sonocotta/loud-esp/hardware/README.md

# ESP Audio Development Kits hardware 

Open Source Hardware
Open Source Software

These are the hardware design files for the ESP32 Audio Development Kit

**Prototype**



**Latest board**

| Assembed | PCB only | 
|---|---|
|  | 

## Features

### Loud-ESP Mini

| IMAGE | DESCRIPTION |
|---|---|
|  |  MCU (WROVER ESP32) <br/>  RESET and IO0/FLASH buttons <br/>  Speaker Terminals <br/>  Li-Ion Battery Connector <br/>  Power switch <br/>  USB port (Flashing + Serial + Power + Charging) <br/>  RGB LED </br>  5V Boost converter

### Loud-ESP

| IMAGE | DESCRIPTION |
|---|---|
|  |  MCU (WROVER ESP32) <br/>  RESET and IO0/FLASH buttons <br/>  Speaker Terminals <br/>  Li-Ion Battery Connector <br/>  Power switch <br/>  USB port (Flashing + Serial + Power + Charging) <br/>  RGB LED </br>  Dual 5V Boost converter <br/>  IR Sensor <br/>  TFT Screen Connector <br />  SD Card socket <br />  Rotary Encoder/Joystick module conector

#### External connectors

| IMAGE | DESCRIPTION |
|---|---|
|  |  External RGB Strip connector. Chained to built-in RGB LED <br />  External Power switch. Short via the external button to power on the board. <br />  External 5V source. Alternative source of power and charging <br />  Disable battery current protection jumper. Short to override built-in 2A current limiter (only if you know what you're doing)

### GAIN and MONO Selection

Both Boards have jumpers that can be used to configure the gain factor individually for both channels. The default GAIN is +9 dB. Short appropriate jumper to override the default
To hardwire DAC into MONO mode, you need to cut the MONO jumper (it is short by default)

| Loud-ESP MINI | Loud-ESP |
|---|---|
|  |  | 

## Board Revisions

These boards comes in multiple revisions, normally the revision of the specific board will be clearly visible on the back side of the PCB.



The current distribution of board revisions looks like this

| Revision | Loud-ESP | Revision | Loud-ESP Mini  | Description
|----|----|----|----|----|
| D |  | - |  | Extended PCB with built-in Rotary Encoder/ Joystick
| E |  | E |  | Pre-production prototype. Distributed among beta-testers
| F |  | F |  | Crowd Supply distribution
| G |  | - | - | Engineering sample that replace serial bridge with CH340 (due to few CP2102 failures reported by customers)
| H |  | - | - | Recent board update, introduce improved power topology, CH340 Serial bridge, USB-C port, and SDCARD over SDIO interface.

Reviosions A, B, and C were early prototypes, never distributed due to multiple hardware issues.

## Pin Definitions



### Pin usage summary

| PIN  | PRIMARY FUNC | JTAG | I2S  | TFT | TOUCH_TFT | RGB_LED | BAT | IR | SDCARD | ROTARY ENC/ BTN INP | PSRAM |
|---|---|---|---|---|---|---|---|---|---|---|---|
| IO0  | BOOT SEL | | | | | | | IR_IN | | | |
| IO1  | TX | | | | | | | | | | |
| IO2  | | | | | CS | | | | | | |
| IO3  | RX | | | | | | | | | | |
| IO4  | | | | DC | | | | | | | |
| IO5  | VSPI_CS | | | CS | | | | | | | |
| IO12 | HSPI_MISO | MTDI | | | | | | | | | |
| IO13 | HSPI_MOSI | MTCK | | | | | | | | | |
| IO14 | HSPI_CLK | MTMS | | | | | | | | | |
| IO15 | HSPI_CS | MTDO | | | | | | | | | |
| IO16 | | | | | | | | | | | PSRAM_CS  |
| IO17 | | | | | | | | | | | PSRAM_CLK |
| IO18 | VSPI_CLK | | | CLK | CLK | | | | CLK | | |
| IO19 | VSPI_MISO | | | MISO | MISO | | | | MISO | | |
| IO21 | | | | | | | CHRG | | | | |
| IO22 | | | DATA | | | | | | | | |
| IO23 | VSPI_MOSI | | | MOSI | MOSI | | | | MOSI | | |
| IO25 | | | WS | | | | | | | | |
| IO26 | | | CLK  | | | | | | | | |
| IO27 | | | | | | | | | CS | | |
| IO32 | | | | RES/LED | | | | | | | |
| IO33 | | | | | | OUT | | | | | |
| IO34 | | | | | | | BAT_IN | | | | |
| IO35 | | | | | | | | | | A | |
| IO36 | | | | | | | | | | B | |
| IO39 | | | | | | | | | | BTN | |

### Rev H update

Key hardware updates introduced in the rev H

- SD-CARD over SDIo interface
- CH340 Serial chip instead of CP2102
  - Few people reported its failure
- USB-C instead of mini-USB
- TPS63060 step-up/step-down 3.3V converter, which ensures smooth operation with low battery levels
  - Previous revision started flickering when battery voltage goes low, since 3V3 rail would go even below 3V, causing ESP32 brown-outs

#### SD-CARD issues

Having used Loud-ESP for a few projects involving SDCARD, I came to the idea that having 3 high-speed devices on the same SPI line is not the best approach. Since SD-CARD alternatively can be connected to the SDIO interface, I decided to follow that path in revision H.

SDIO interface is hardwired to pins IO2, IO4, IO12-15, and by the SD specification, **all must be pulled high** for reliable operation. At the same time, ESP32 specification states that **pins 2 and 12 must be low at boot**, otherwise ESP32 will go into download mode. Thus, I left them floating, which caused some SD cards to fail. I didn't find a reliable solution to this contradiction and consider going back to the SPI interface in the next revision.

#### Updated pinout

| PIN  | PRIMARY FUNC | JTAG | I2S  | TFT  | TOUCH_TFT | RGB_LED | BAT | IR | SDCARD | ROTARY ENC/ BTN INP | PSRAM |
|---|---|---|---|---|---|---|-----|---|---|---|---|
| IO0  | BOOT SEL | | | | | | | IR_IN | | | |
| IO1  | TX | | | | | | | | | | |
| IO2  | | | | | | | | | D0 | | |
| IO3  | RX | | | | | | | | | | |
| IO4  | | | | | | | | | D1 | | |
| IO5  | VSPI_CS | | | CS | | | | | | | |
| IO12 | HSPI_MISO | MTDI | | | | | | | D2 | | |
| IO13 | HSPI_MOSI | MTCK | | | | | | | D3 | | |
| IO14 | HSPI_CLK | MTMS | | | | | | | CLK | | |
| IO15 | HSPI_CS | MTDO | | | | | | | CMD | | |
| IO16 | | | | | | | | | | | PSRAM_CS  |
| IO17 | | | | | | | | | | | PSRAM_CLK |
| IO18 | VSPI_CLK | | | CLK  | CLK | | | | CLK | | |
| IO19 | VSPI_MISO | | | MISO | MISO | | | | MISO | | |
| IO21 | | | | DC | | | | | | | |
| IO22 | | | DATA | | | | | | | | |
| IO23 | VSPI_MOSI | | | MOSI | MOSI | | | | MOSI | | |
| IO25 | | | WS | | | | | | | | |
| IO26 | | | CLK  | | | | | | | | |
| IO27 | | | | | CS | | | | | | |
| IO32 | | | | LED  | | | | | | | |
| IO33 | | | | | | OUT | | | | | |
| IO34 | | | | | | | | | | B | |
| IO35 | | | | | | | | | | A | |
| IO36 | | | | | | | | | | BTN | |
| IO39 | | | | | | | | | HOST | | |

### How to use a specific peripheral

[esp32-peripheral-test](../firmware/test-peripheral/esp32-peripheral-test) firmware demonstrates how to use each of available peripheral. For many of them, you would need libraries, which are also included in this example. Of couse many alternatives can be found, example will list those that are tested and work without a hustle.
