sonocotta/loud-esp/hardware/loud-esp-rfid-edition/rev-g/2506-loud-esp-g-espuino-edition-bom.csv

ID | Name | Designator | Footprint | Quantity | Manufacturer Part | Manufacturer | Supplier | Supplier Part | Price
1 | BH-18650-B1BA002 | BT1 | BATTERY-SMD_18650-1S-L77.1-W20.7-1 | 1 | BH-18650-B1BA002 | MYOUNG(美阳) | LCSC | C2988620 | 1.31
2 | 100nF | C15,C28,C31,C32,C33,C34,C36,C39,C40,C41,C42,C43,C6,C12,C16,C21 | C0402 | 16 | CL05B104KO5NNNC | SAMSUNG | LCSC | C1525 | 0.001
3 | 1uH | L1,L2 | IND-SMD_L4.0-W4.0_SLW40XX | 2 | WPN4020H1R0MT | Sunlord(顺络) | LCSC | C98359
4 | XL-0807RGBC-WS2812B | U11,U12,U13,U14,U15,U16,U17,U18,U19,U20,U21,U22 | LED-SMD_4P-L2.0-W1.8_CY-0807 | 12 | XL-0807RGBC-WS2812B | XINGLIGHT(成兴光) | LCSC | C3646929 | 0.095
5 | 10uF | C9 | C0805 | 1 | CL21A106KAYNNNE | SAMSUNG(三星) | LCSC | C15850 | 0.011
6 | 680kΩ | R33,R43 | R0603 | 2 | 0603WAF6803T5E | UNI-ROYAL(厚声) | LCSC | C25822 | 0.001
7 | 300kΩ | R53 | R0402 | 1 | 0402WGF3003TCE | UNI-ROYAL(厚声) | LCSC | C25774 | 0.001
8 | 1uF | C7,C8,C18,C45 | C0402 | 4 | CL05A105KA5NQNC | SAMSUNG(三星) | LCSC | C52923 | 0.003
9 | ESP32-WROVER-E-N8R8 | U10 | WIFI-SMD_ESP32-WROVER-IE8MB | 1 | ESP32-WROVER-E-N8R8 | ESPRESSIF(乐鑫) | LCSC | C2973667 | 4.182
10 | HDR-F-2.54_1x8 | H1 | HDR-F-2.54_1X8 | 1 |  |  | LCSC | C225505 | 0.204
11 | IRF7319TRPBF_C5123893 | Q4 | SOIC-8_L4.9-W3.9-P1.27-LS6.0-BL | 1 | IRF7319TRPBF | TECH PUBLIC(台舟) | LCSC | C5123893 | 0.165
12 | 100kΩ | R25,R19,R22 | R0603 | 3 | 0603WAF1003T5E | UNI-ROYAL(厚声) | LCSC | C25803 | 0.001
13 | 510kΩ | R26,R18,R32,R36 | R0603 | 4 | 0603WAF5103T5E | UNI-ROYAL(厚声) | LCSC | C23192 | 0.001
14 | TS-1095S-A16B2-C2D1 | SW7,SW3,SW4,SW5,SW6,SW8 | KEY-SMD_4P-L6.0-W6.0-P4.50-LS8.6 | 6 | TS-1095S-A16B2-C2D1 | Yuandi(元迪) | LCSC | C782843 | 0.046
15 | 100nF | C1,C2,C25 | C0603 | 3 | CC0603KRX7R9BB104 | YAGEO | LCSC | C14663 | 0.002
16 | 10uF | C3,C26,C27,C35 | C0805 | 4 | CL21A106KAYNNNE | SAMSUNG | LCSC | C15850 | 0.011
17 | 100uF | C4,C29,C30,C37,C38 | CAP-SMD_L3.5-W2.8 | 5 | TAJB107K006RNJ | AVX | LCSC | C16133 | 0.372
18 | 10uF | C5 | C0603 | 1 | CL10A106KP8NNNC | SAMSUNG | LCSC | C19702 | 0.006
19 | 10uF | C10,C11,C13,C14,C19,C20,C22,C23 | C0402 | 8 | CL05A106MQ5NUNC | SAMSUNG(三星) | LCSC | C15525 | 0.005
20 | 10pF | C17,C24 | C0402 | 2 | CL05C100JB5NNNC | SAMSUNG(三星) | LCSC | C32949 | 0.005
21 | PH2.0-2PWB | CN1 | CONN-SMD_2P-P2.00_PH2.0-SPWB | 1 | PH-2P卧贴 | BOOMELE(博穆精密) | LCSC | C47647 | 0.059
22 | 1N5819WS | D2 | SOD-323_L1.8-W1.3-LS2.5-RD | 1 | 1N5819WS | Hottech(合科泰) | LCSC | C191023 | 0.01
23 | B5819W_C8598 | D3,D1 | SOD-123_L2.7-W1.6-LS3.7-RD-1 | 2 | B5819W SL | CJ(江苏长电/长晶) | LCSC | C8598 | 0.022
24 | IRM-H638T/TR2(DX) | LED1 | SENSOR-SMD_IRM-H638T-TR2-DX | 1 | IRM-H638T/TR2(DX) | Everlight Elec | LCSC | C390031 | 0.31
25 | FC-2012HRK-620D | LED2 | LED0805-R-RD | 1 | NCD0805R1 | 国星光电 | LCSC | C84256 | 0.014
26 | 17-21SUYC/TR8 | LED3 | LED0805-R-RD | 1 | KT-0805黄灯 | KENTO | LCSC | C2296 | 0.012
27 | 100 | R1,R2,R15 | R0402 | 3 | 0402WGF1000TCE | UniOhm | LCSC | C25076 | 0.001
28 | 10K | R3,R5,R7,R8,R9,R10,R11,R12,R13,R14,R16,R17,R29,R31,R41,R45,R46,R47,R48,R49,R50,R51,R52 | R0402 | 23 | 0402WGF1002TCE | UniOhm | LCSC | C25744 | 0.001
29 | 1MΩ | R20,R23,R30,R34 | R0603 | 4 | 0603WAF1004T5E | UNI-ROYAL(厚声) | LCSC | C22935 | 0.001
30 | 10kΩ | R21 | R0402 | 1 | 0402WGF1002TCE | UNI-ROYAL(厚声) | LCSC | C25744 | 0.001
31 | 100K | R24 | R0402 | 1 | 0402WGF1003TCE | UniOhm | LCSC | C25741 | 0.001
32 | 5.1kΩ | R27,R28 | R0402 | 2 | 0402WGF5101TCE | UNI-ROYAL(厚声) | LCSC | C25905 | 0.001
33 | 51kΩ | R35 | R0402 | 1 | 0402WGF5102TCE | UNI-ROYAL(厚声) | LCSC | C25794 | 0.001
34 | 2kΩ | R37,R38 | R0402 | 2 | 0402WGF2001TCE | UNI-ROYAL(厚声) | LCSC | C4109 | 0.001
35 | 100K (+3Db) | R39,R42 | R0402 | 2 | 0402WGF1003TCE | UniOhm | LCSC | C25741 | 0.001
36 | 100K (+15Db) | R44,R40 | R0402 | 2 | 0402WGF1003TCE | UniOhm | LCSC | C25741 | 0.001
37 | EC11N1525405 | SW1 | SW-TH_EC11NXXXX | 1 | EC11N1525405 | ALPSALPINE(阿尔卑斯阿尔派) | LCSC | C470749 | 1.987
38 | TS-1088-AR02016 | SW2 | SW-SMD_L3.9-W3.0-P4.45 | 1 | TS-1088-AR02016 | XUNPU(讯普) | LCSC | C720477 | 0.044
39 | CH340C | U1 | SOP-16_L10.0-W3.9-P1.27-LS6.0-BL | 1 | CH340C | WCH | LCSC | C84681 | 0.536
40 | TPS63060DSCR | U2,U3 | WSON-10_L3.0-W3.0-P0.50-BL-EP-A | 2 | TPS63060DSCR | TI(德州仪器) | LCSC | C48567 | 0.968
41 | TP4056 | U4 | ESOP-8_L4.9-W3.9-P1.27-LS6.0-BL-EP | 1 | TP4056-42-ESOP8 | TOPPOWER(南京拓微) | LCSC | C16581 | 0.177
42 | LEFT CHANNEL | U6 | CONN-TH_P3.50_KF350-3.5-2P | 1 | KF350-3.5-2P | Cixi Kefa Elec | LCSC | C474892 | 0.108
43 | RIGHT CHANNEL | U8 | CONN-TH_P3.50_KF350-3.5-2P | 1 | KF350-3.5-2P | Cixi Kefa Elec | LCSC | C474892 | 0.108
44 | PCA9555PW,118 | U9 | TSSOP-24_L7.8-W4.4-P0.65-LS6.4-BL | 1 | PCA9555PW,118 | NXP(恩智浦) | LCSC | C128392 | 0.802
45 | TYPE-C 16PIN 2MD(073) | USB1 | USB-C-SMD_TYPE-C-6PIN-2MD-073 | 1 | TYPE-C 16PIN 2MD(073) | SHOU HAN(首韩) | LCSC | C2765186 | 0.058
46 | S8050_C2146 | Q1,Q2 | SOT-23-3_L3.0-W1.7-P0.95-LS2.9-BR | 2 | S8050 | CJ | LCSC | C2146 | 0.013
47 | TF-01A | CARD1 | TF-SMD_TF-01A | 1 | TF-01A | HRO | LCSC | C91145 | 0.174
48 | MAX98357AETE+T | U5,U7 | TQFN-16_L3.0-W3.0-P0.50-BL-EP1.5 | 2 | MAX98357AETE+T | MAXIM(美信) | LCSC | C910544 | 1.339
49 | AO3401A | Q3 | SOT-23_L2.9-W1.3-P1.90-LS2.4-BR | 1 | AO3401A | AOS | LCSC | C15127 | 0.059
