sonocotta/loud-esp/hardware/loud-esp-rfid-edition/rev-g/2506-loud-esp-g-espuino-edition-3d.step

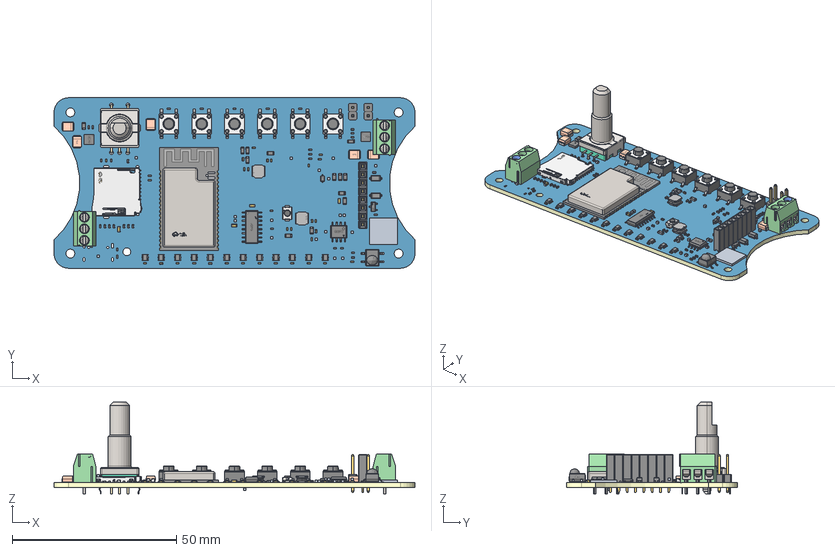
[picture p1: CAD file, 2025-10-29]
hardware/loud-esp-rfid-edition/rev-g/2506-loud-esp-g-espuino-edition-3d.step
110.0 x 52.0 x 28.0 mm
Board~B1yR
TopCopper~B1yR
BottomCopper~B1yR
TopFpcStiffener~B1yR
BottomFpcStiffener~B1yR
BATTERY-SMD_18650-1S-L77.1-W20.7-1~BATTERY-SMD_ 18650-1S-L77.1-W20.7-1~B1yR
C0805~C0805_L2.0-W1.3-H1.3~B1yR x 3
C35~C0805~C0805_L2.0-W1.3-H1.3~B1yR x 2
LED-SMD_4P-L2.0-W1.8_CY-0807~LED-SMD_4P-L2.0-W1.8_CY-0807~B1yR x 12
C0402~C0402_L1.0-W0.5-H0.5~B1yR x 30
SOIC-8_L4.9-W3.9-P1.27-LS6.0-BL~SOIC-8_L4.9-W3.9-H1.7-LS6.0-P1.27~B1yR
R0603~R0603~B1yR x 13
IND-SMD_L4.0-W4.0_SLW40XX~IND-SMD_L4.0-W4.0-H2.0_SLW40XX~B1yR x 2
R0402~R0402_L1.0-W0.5-H0.5~B1yR x 34
WIFI-SMD_ESP32-WROVER-IE8MB~WIFI-SMD_ L31.4-W18.0-H3.3-ESP32-WROVER-E~B1yR
C0603~C0603_L1.6-W0.8-H0.8~B1yR x 4
KEY-SMD_4P-L6.0-W6.0-P4.50-LS8.6~KEY-SMD_ 4P-L6.0-W6.0-H5.0-LS10.0-P4.50~B1yR x 6
CAP-SMD_L3.5-W2.8~CASE-B_L3.5-W2.8-H1.9~B1yR x 5
SOD-323_L1.8-W1.3-LS2.5-RD~SOD-323_L1.7-W1.3-H1.1-LS2.5~B1yR
SOD-123_L2.7-W1.6-LS3.7-RD-1~SOD-123_L2.7-W1.6-LS3.7-RD-1~B1yR x 2
HDR-M-2.54_1X2~HDR-M-2.54_1x2~B1yR x 2
HDR-F-2.54_1X8~HDR-F-2.54_1x8~B1yR
SENSOR-SMD_IRM-H638T-TR2-DX~SENSOR-SMD_L5.0-W4.0-H4.0-LS7.0-P2.54~B1yR
CONN-SMD_2P-P2.00_PH2.0-SPWB~CONN-SMD_2P-P2.00_PH2.0-SPWB~B1yR
SW-TH_EC11NXXXX~SW-TH_EC11NXXXX-L11.7-W12.0-H24.5-P2.5-LS14.5~B1yR
SW-SMD_L3.9-W3.0-P4.45~SW-SMD_L3.9-W2.9-H2.0-LS4.8~B1yR
LED3~LED0805-R-RD~LED0805-RD~B1yR x 2
R38~R0402~R0402_L1.0-W0.5-H0.4~B1yR x 6
TSSOP-24_L7.8-W4.4-P0.65-LS6.4-BL~TSSOP-24_ L7.8-W4.4-H1.0-LS6.4-P0.65~B1yR
SOP-16_L10.0-W3.9-P1.27-LS6.0-BL~SOP-16_ L9.9-W3.9-H1.5-LS6.0-P1.27~B1yR
ESOP-8_L4.9-W3.9-P1.27-LS6.0-BL-EP~ESOP-8_ L4.9-W3.9-H1.6-LS6.0-P1.27~B1yR
CONN-TH_P3.50_KF350-3.5-2P~CONN-TH_P3.50_KF350-3.5-2P~B1yR x 2
TQFN-16_L3.0-W3.0-P0.50-BL-EP1.5~TQFN-16_L3.0-W3.0-H0.8-P0.50~B1yR x 2
SOT-23_L2.9-W1.3-P1.90-LS2.4-BR~SOT-23-3P_ L2.9-W1.3-H1.0-LS2.4-P0.95~B1yR
USB-C-SMD_TYPE-C-6PIN-2MD-073~USB-C-SMD_TYPE-C-6PIN-2MD-073~B1yR
Q2~SOT-23-3_L3.0-W1.7-P0.95-LS2.9-BR~SOT-23-3L_ L2.9-W1.6-H1.1-LS2.8-P0.95~B1yR x 2
TF-SMD_TF-01A~TF-SMD_L14.8-W14.5-H1.9-P1.1~B1yR
