sonocotta/loud-esp/(threads)

Thread 2 (2022-07-27):

Update

fl0r1s, 2022-07-27:
Hi

I was looking to build several wifi speakers with DAC for my home multiroom audio solution, I would like to contribute or pre-order if that would already be possible. I saw that the latest activity was 4m ago, are you still working on this project? Looks super cool.

anabolyc, 2022-07-27:
Hi @fl0r1s . I'm working on the Crowd Supply campaign at the moment, and hope that boards will be available for buying soon. At this moment I can offer you pre-production samples for beta-testing. Please reach me out at andriy@sonocotta.com, I'd really like to hear what are you building and how can I support you in it.

anabolyc, 2023-03-02:
Hi @fl0r1s . [Campaign](https://www.crowdsupply.com/sonocotta/loud-esp) is live now.

Thread 3 (2022-12-15):

Actual hardware source CAD is missing

Goury, 2022-12-15:
Where is it?
Can't find it, PDF is not source code, it's mostly useless.

anabolyc, 2022-12-15:
Hi @Goury it is created in web IDE, so not much more I can share in terms of schematics. As for PCB, I can (and will) upload PDFs for PCB as well.

Can you please share what are you looking for exactly?

Goury, 2022-12-15:
@anabolyc it was created in EasyEDA, so you can totally share wither by a link or by exporting a file (yup, it does let you save a file locally)
Please do that, a PDF is useless.

Right-click the project in the Project tab, manage→share, fill the form, get the link
Here's an example: https://oshwlab.com/goury/light

anabolyc, 2022-12-15:
> it does let you save a file locally

Good to know. But since I'm in the middle of crowd supply campaign preparation, I'm sure you'll understand, not looking to provide an easy way to clone the board.

> PDF is useless

again useless for what exactly? what are you trying to do?

Goury, 2022-12-15:
> what are you trying to do?

@anabolyc clone the board of course.

You can't claim it's under GNU GPL or call it "free hardware" if you don't share the actual source.
At least sell the source files for a price.
Or put a promise to release em at a certain date and

Goury, 2022-12-15:
Also github GUI is &#%!

anabolyc, 2022-12-15:
I'm plan to release full source after campaign finishes. For now cannot give you exact date though.

anabolyc, 2022-12-15:
I'm plan to release full source after campaign finishes. For now cannot give you exact date though.

> You can't claim it's under GNU GPL or call it "free hardware" if you don't share the actual source.

I'm pretty sure I can. You have schematics, you're free to use it in your work. Open hardware doesn't imply easy cloning, I'm afraid

Goury, 2022-12-15:
> plan to release

Noice, ping this thread when it happens please.

> Open hardware doesn't imply easy cloning

It does, but I don't feel like challenging this in a court of law.
One of the ideas is that no one is in control of the hardware
If a user can't easily clone of modify it, it's not open.

01GOD, 2023-09-06:
Sigh...such a letdown. Totally thought the EDA files were in the repo because it said "open source".

I'd truly appreciate the EDA files. I have one of those touchscreens here now. I'm planning to modify it, but I'd appreciate it as a good PCB design reference as I am still learning PCB design.

Thanks in advance for posting those EDA files this week.

01GOD, 2023-09-06:
The crowdfunding page said that was fully funded in April and it's already September now.

anabolyc, 2023-09-06:
Hey @Goury @01GOD just [added](https://github.com/sonocotta/esp32-audio-development-kit/commit/d3850d11cdd37943bcafe332e667b731caa46f93) EasyEDA exported jsons. You may have a look.

01GOD, 2023-09-08:
@anabolyc : Thanks for posting those. Sadly the schematic and PCB seem to be unlinked when opened that way though. Posting that on oshwlab.com (it's a JLC thing) would make it easy to open directly in the editor and the schematic and PCB should stay linked that way. Alternatively, can export Altium project from EasyEDA. On the right track though, so thanks in advance for posting that!

01GOD, 2023-09-08:
@anabolyc : PS: Recommend the best online repository of PCB modules? (common modules, such as DAC reference board designs and so on) Thankfully at the point where ready to build board designs from such modules.

Closed 2024-04-25.

Thread 10 (2024-04-25):

Hardware pull request proposals.

picli3, 2024-04-25:
Hi Sonocotta.

I have done a project similar to this, for a different purpose. I'm mainly interested in your code. I don't know how open you are to accepting pull requests for PCB redesign but in Kicad.

my website is [personal web](https://maykolrey.com)

anabolyc, 2024-04-26:
Hi @picli3

This project evolved into [esparagus-media-center](https://github.com/sonocotta/esparagus-media-center), so I do not expect too many changes to come into the design. If the Kicad version would help you develop your variation, go ahead. If I can help, let me know. But for me personally, the Kicad version would not present too much value.

I would propose you to continue your work in the fork. I think this would present a good use case for a new open-source product that is based on the top of the other open-source project

Closed 2025-05-30.
