sonocotta/loud-esp/hardware/esp32-audio-dev-mini/loud-esp-mini-rev-e-schematic.pdf

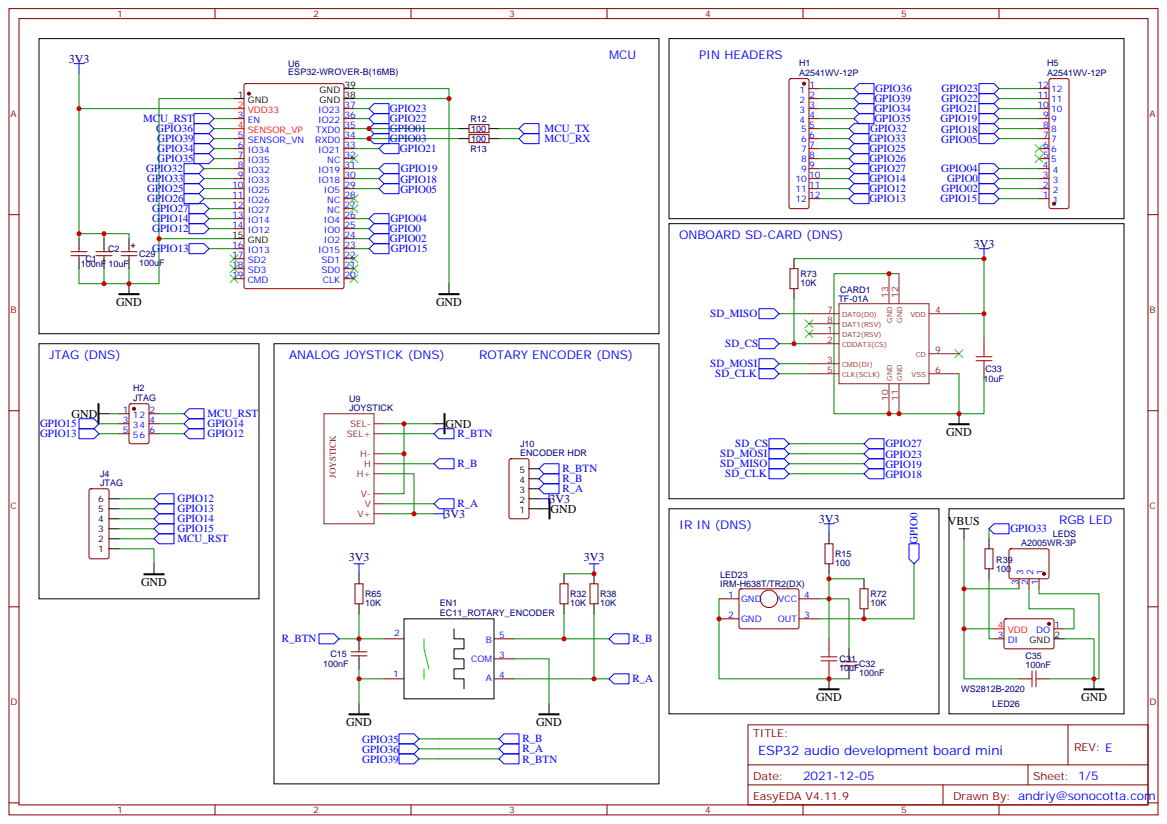
[picture p2: page 1]

ONBOARD SD-CARD (DNS)

TITLE:
ESP32 audio development board mini

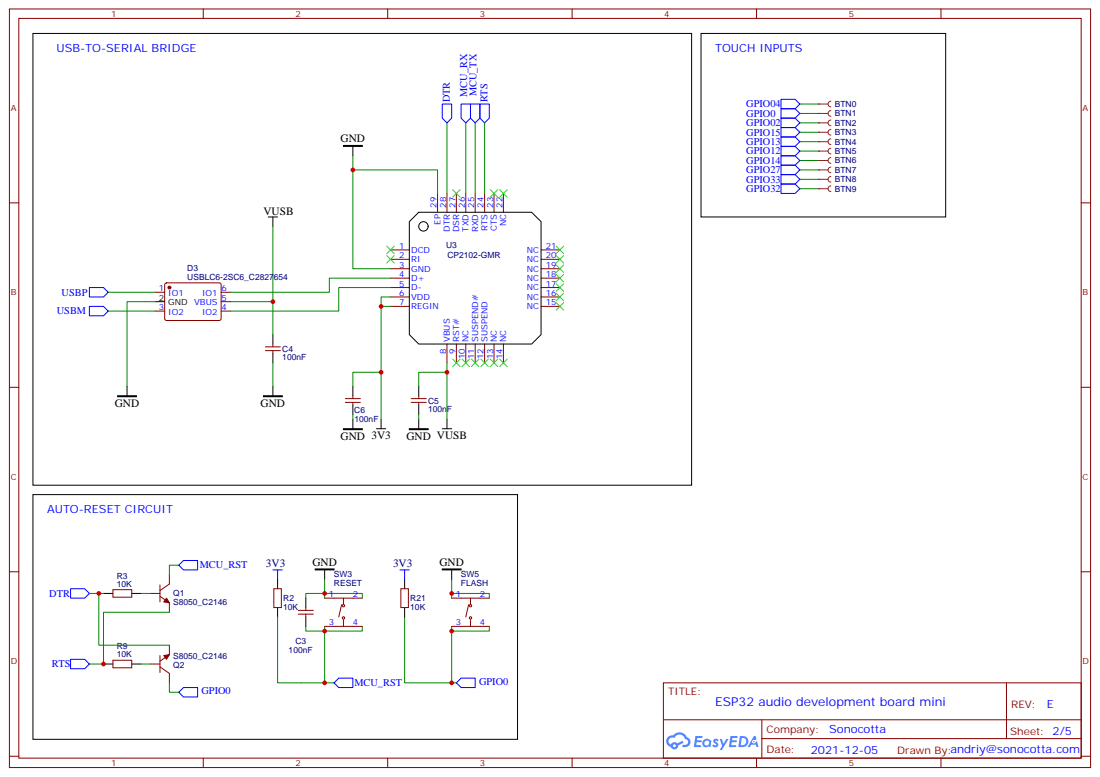
[picture p3: page 2]

USB-TO-SERIAL BRIDGE

NC 22 CTS 23 RTS 24 RXD 25 TXD 26 DSR 27 DTR 28 EP 29

Drawn By:andriy@sonocotta.com

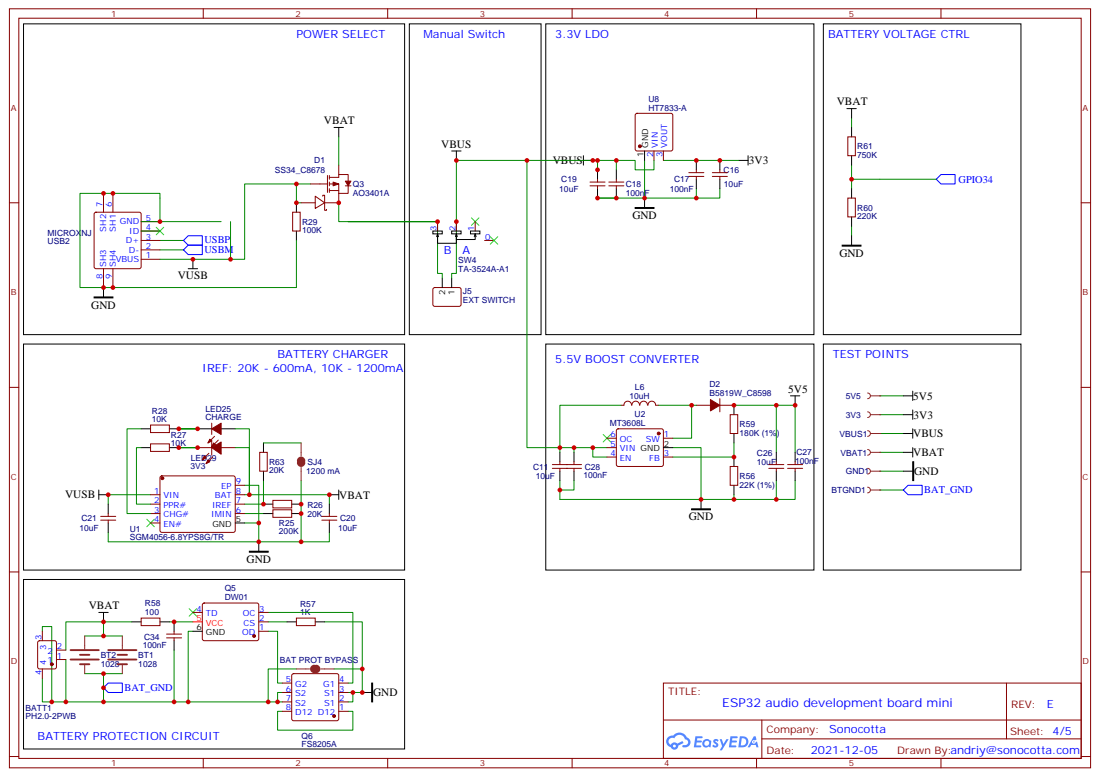
[picture p4: page 3]

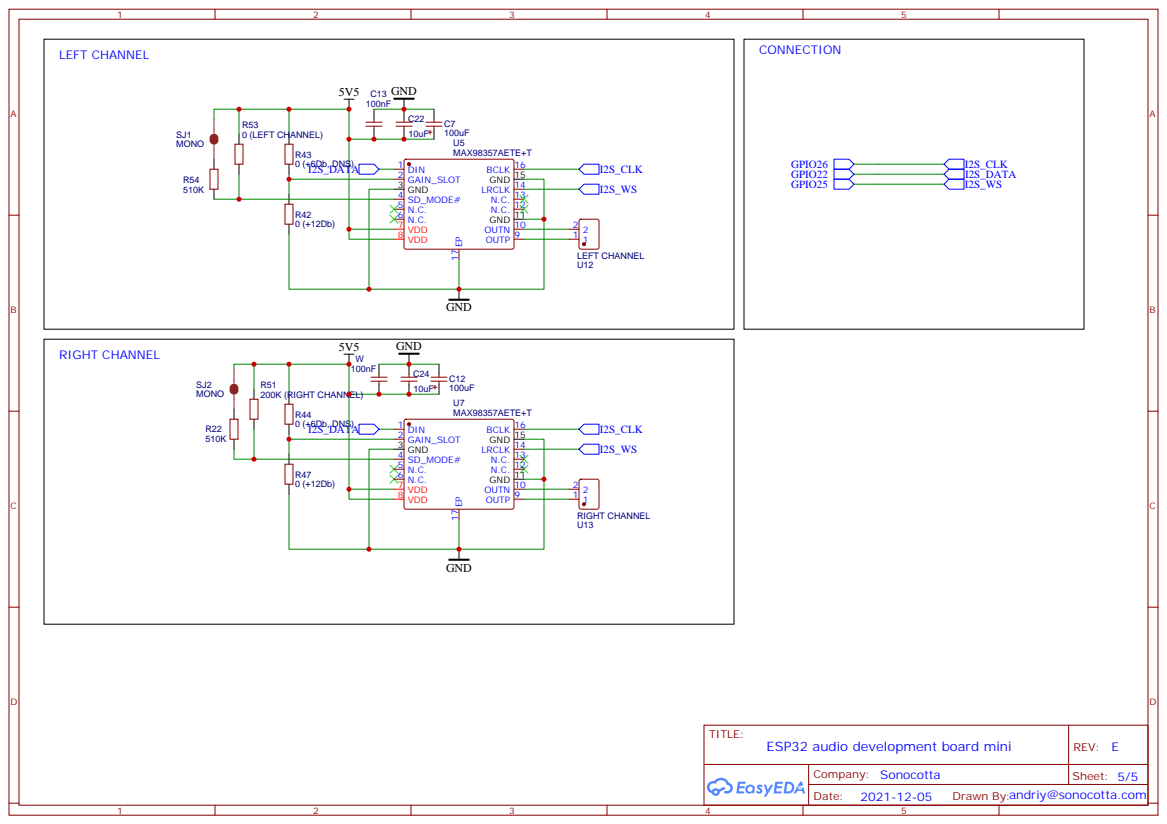
[picture p5: page 4]
