sonocotta/loud-esp/hardware/esp8266-audio-dev-mini/esp8266-audio-board-mini-rev-E.pdf

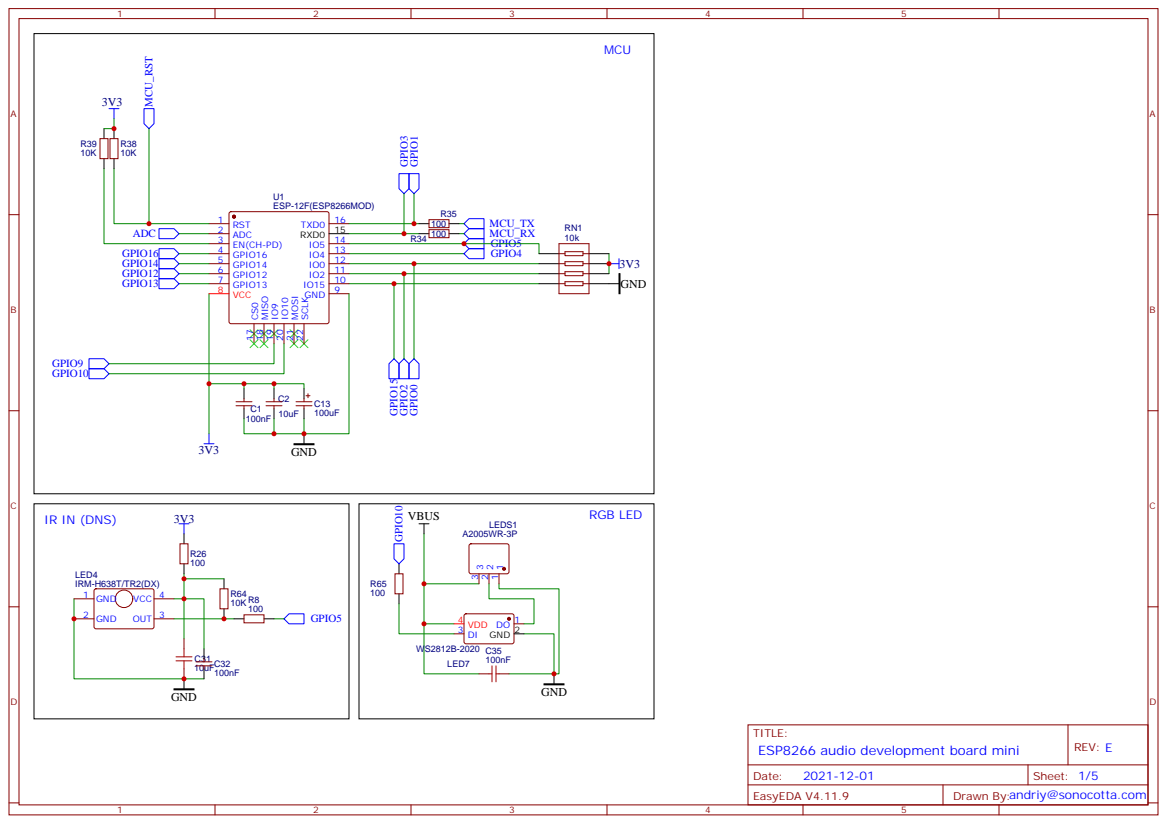
[picture p6: page 1]

TITLE:
ESP8266 audio development board mini

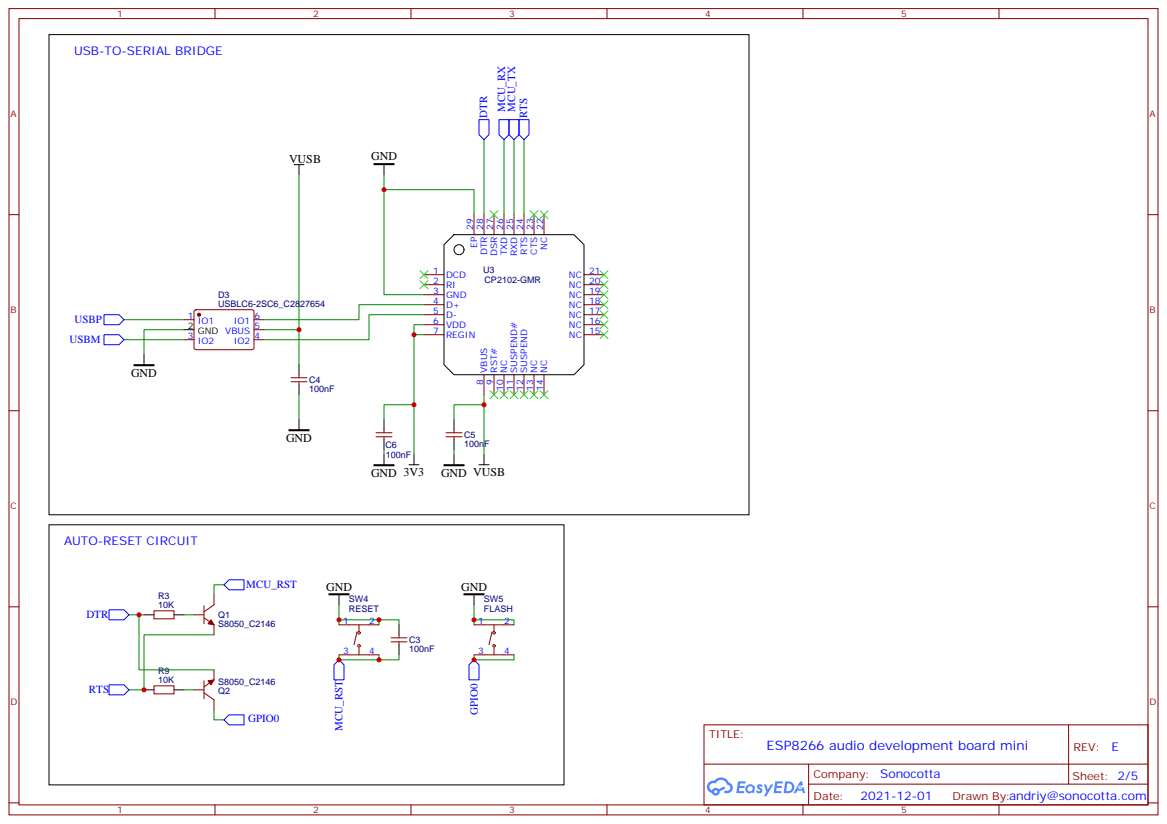
[picture p7: page 2]

USB-TO-SERIAL BRIDGE

NC 22 CTS 23 RTS 24 RXD 25 TXD 26 DSR 27 DTR 28 EP 29

Drawn By:andriy@sonocotta.com

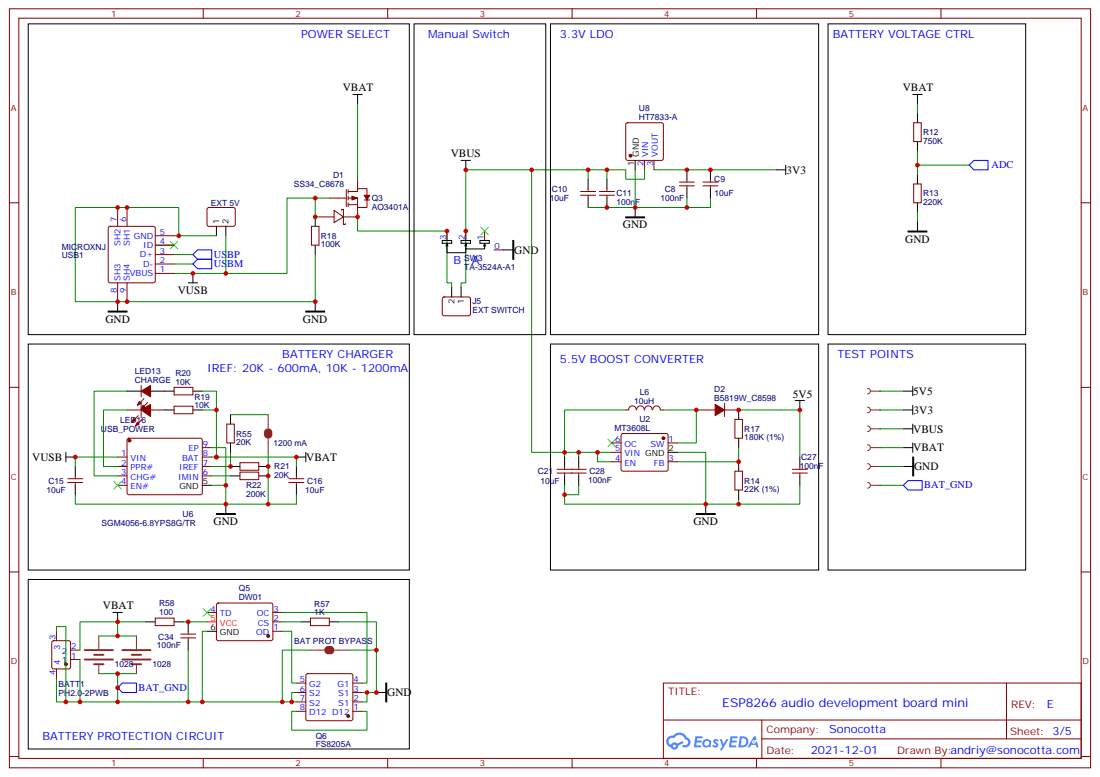
[picture p8: page 3]

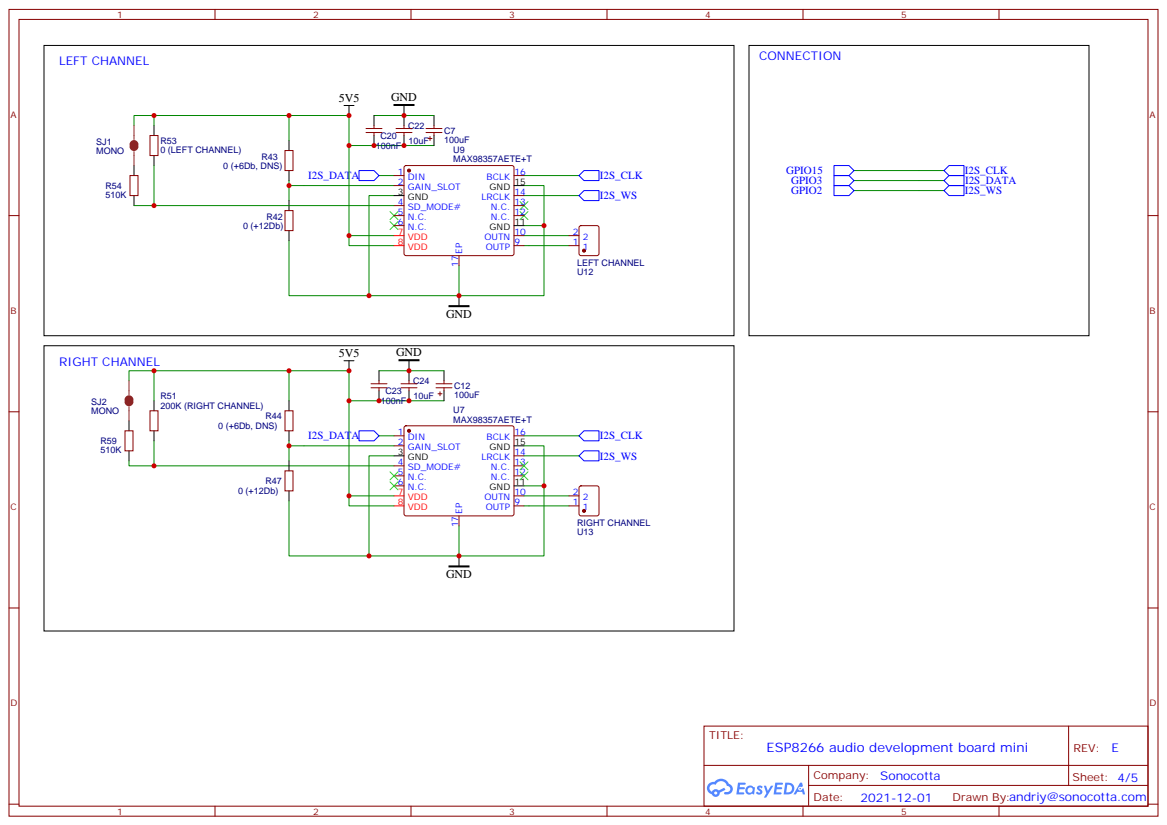
[picture p9: page 4]
