sonocotta/loud-esp/hardware/esp32-audio-dev/rev-h/2504-loud-esp-h-schematics.pdf

## MCU

## USB-TO-SERIAL BRIDGE

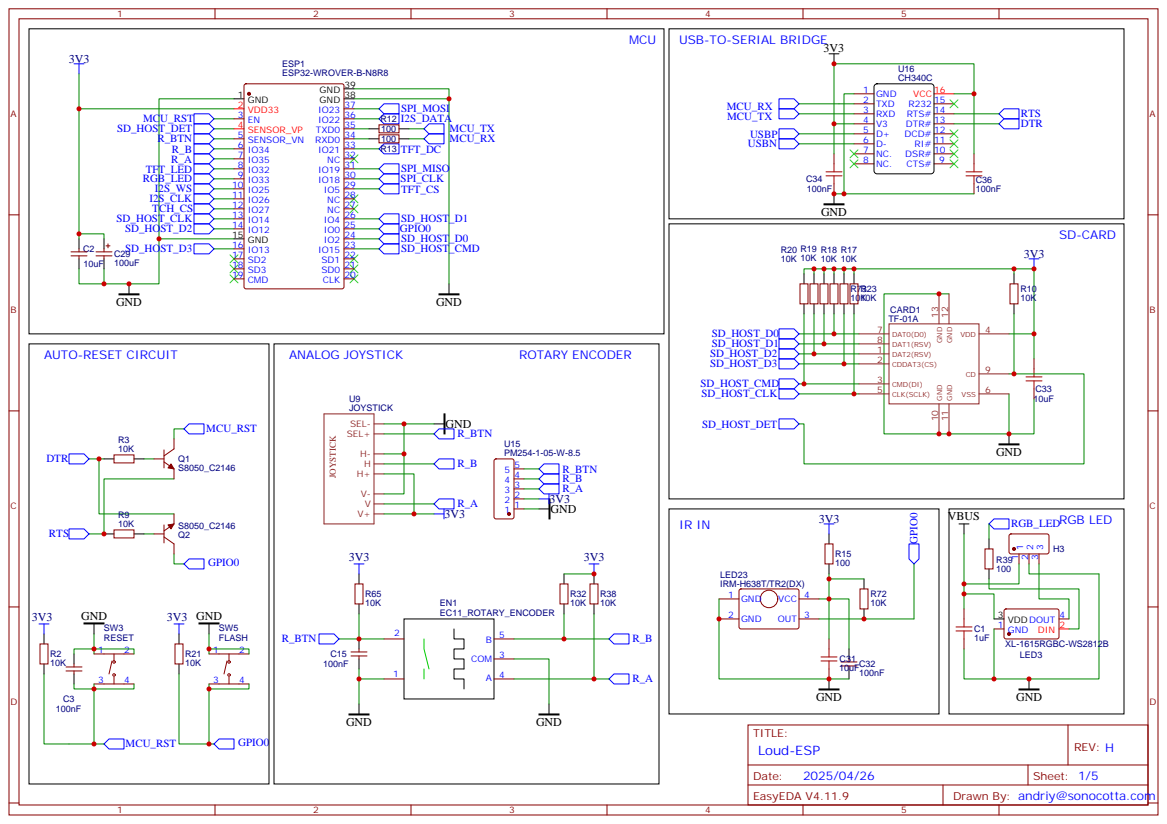
[picture p10: page 1]

POWER SELECT | Manual Switch | 3.3V LDO

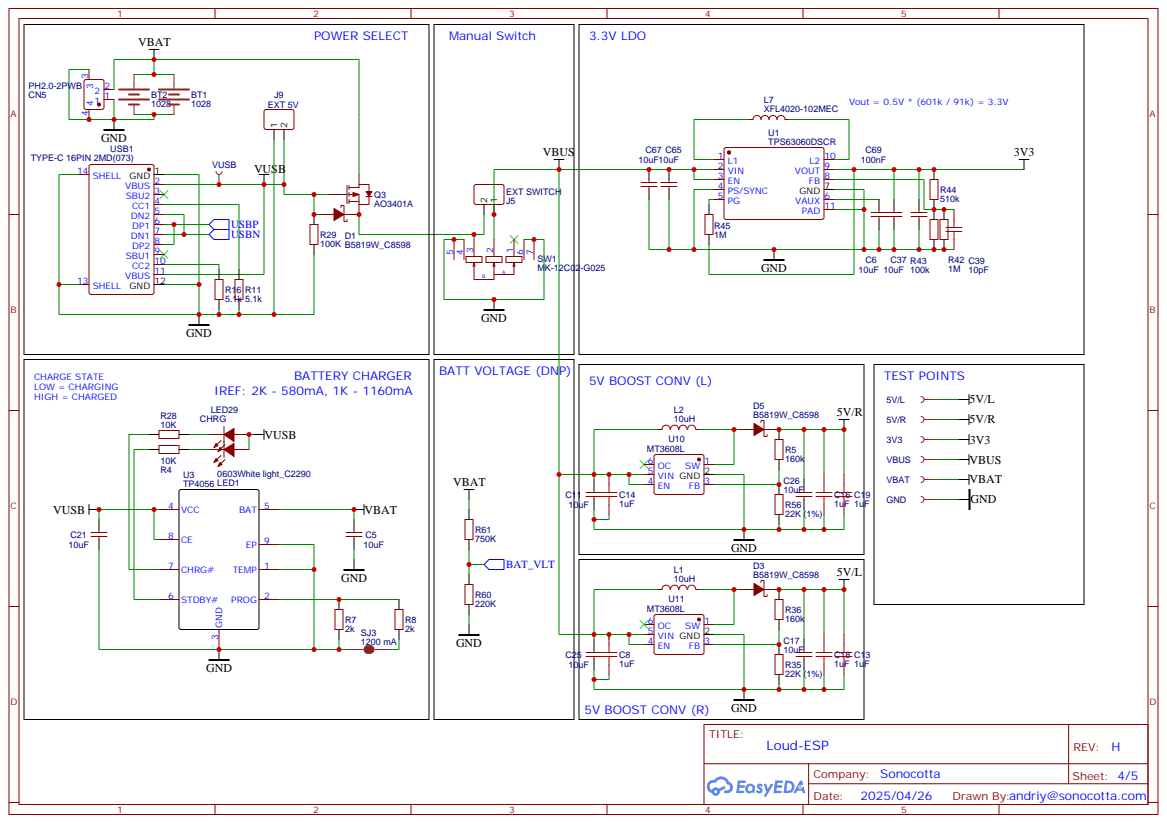
[picture p11: page 2]

BATT VOLTAGE (DNP) BATTERY CHARGER

Drawn By:andriy@sonocotta.com

## LEFT CHANNEL (L) SD_MODE HIGH, CUT TO SWITCH TO MONO (R_LARGE ~634K)

## 2.4' ST7789 TFT

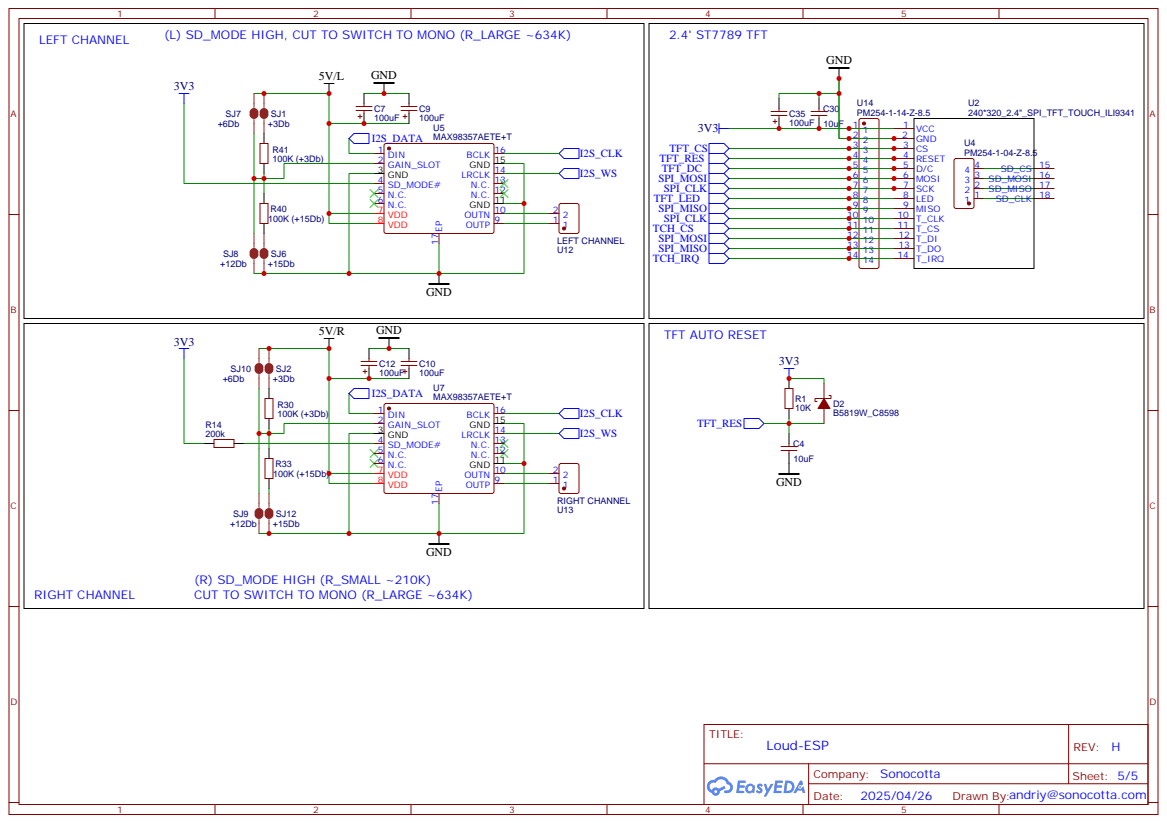
[picture p12: page 3]

(R) SD_MODE HIGH (R_SMALL ~210K)
CUT TO SWITCH TO MONO (R_LARGE ~634K)

Drawn By:andriy@sonocotta.com
