sonocotta/loud-esp/hardware/loud-esp-mini/rev-f/loud-esp-mini-rev-f-schematic.pdf

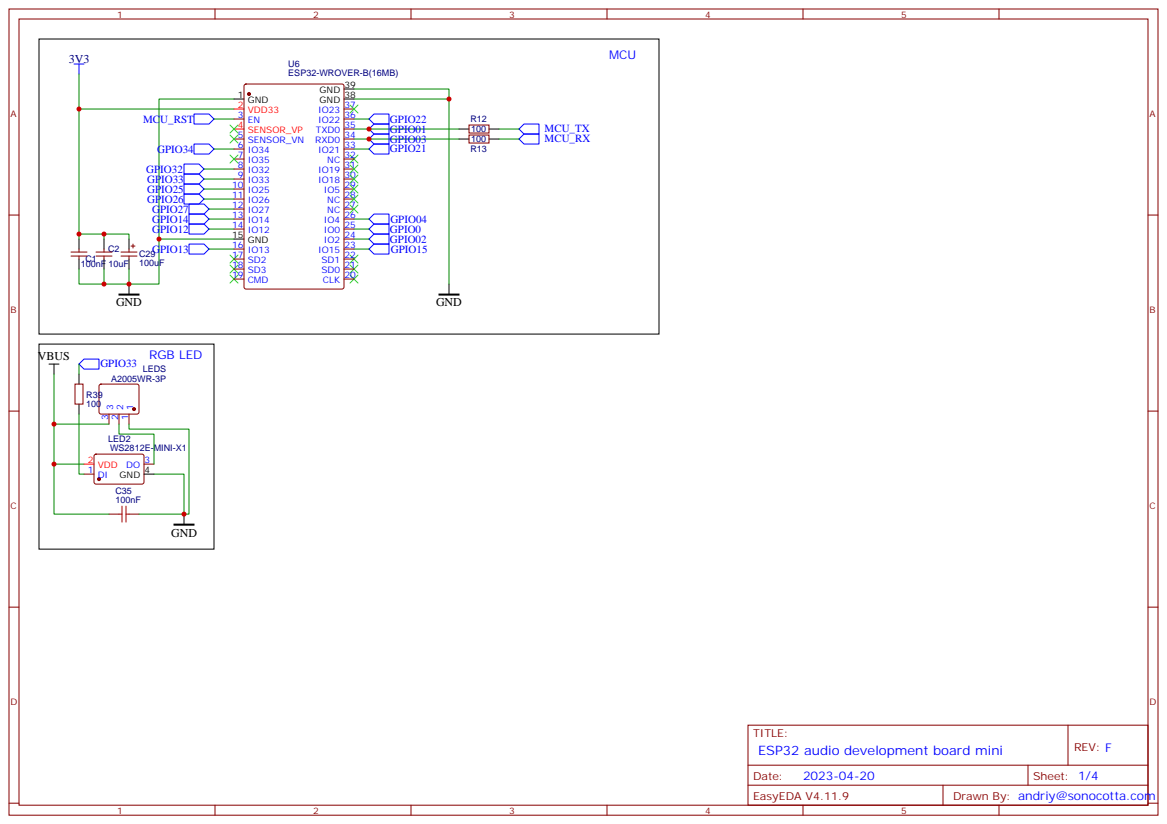
[picture p13: page 1]

TITLE:
ESP32 audio development board mini

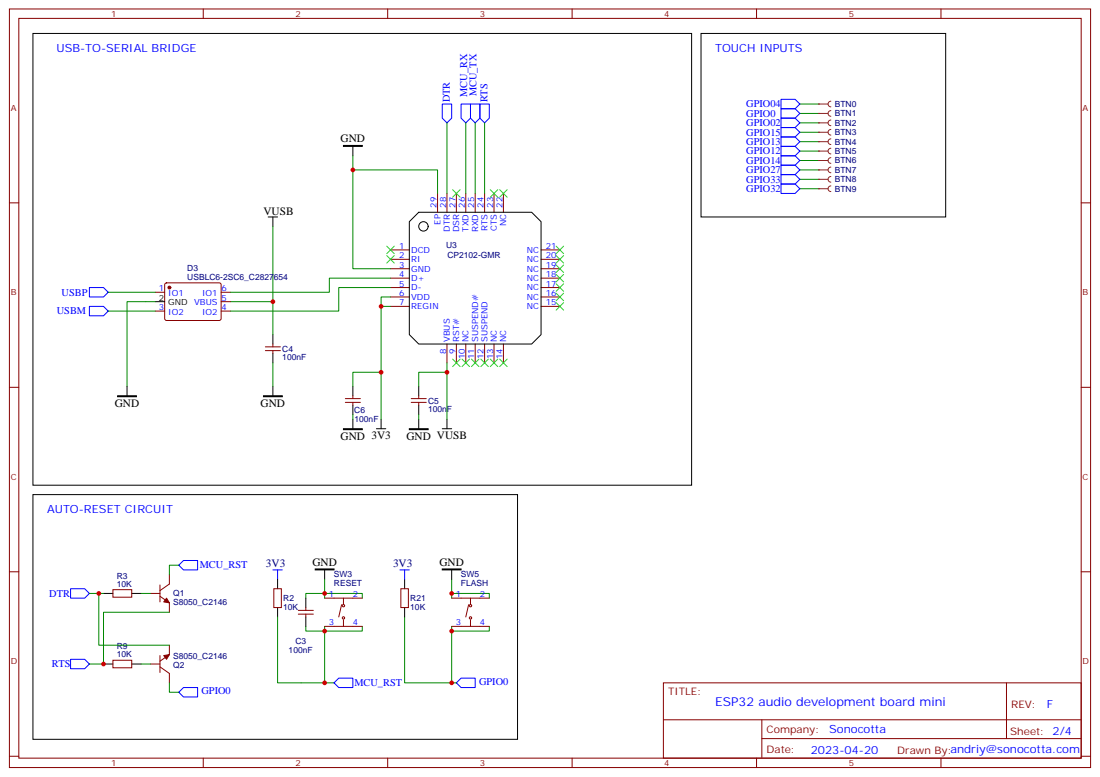
[picture p14: page 2]

USB-TO-SERIAL BRIDGE

NC 22 CTS 23 RTS 24 RXD 25 TXD 26 DSR 27 DTR 28 EP 29

Drawn By:andriy@sonocotta.com

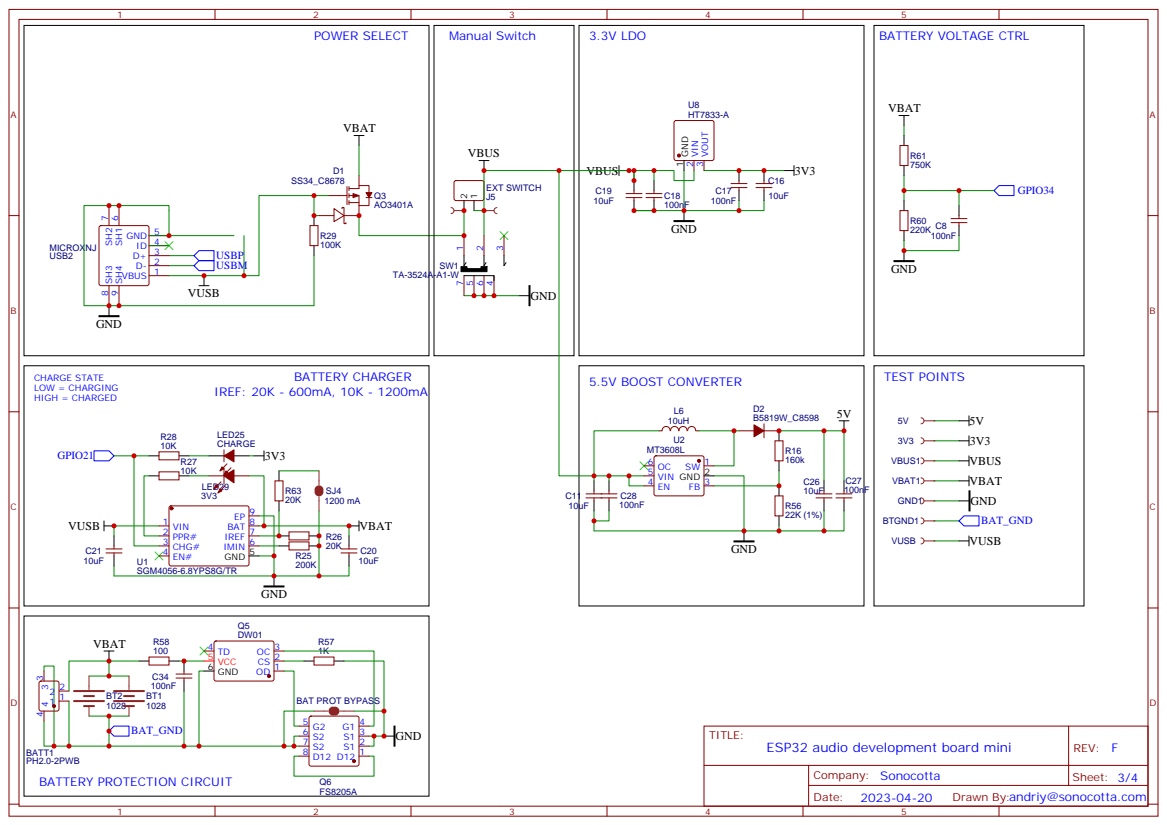
[picture p15: page 3]

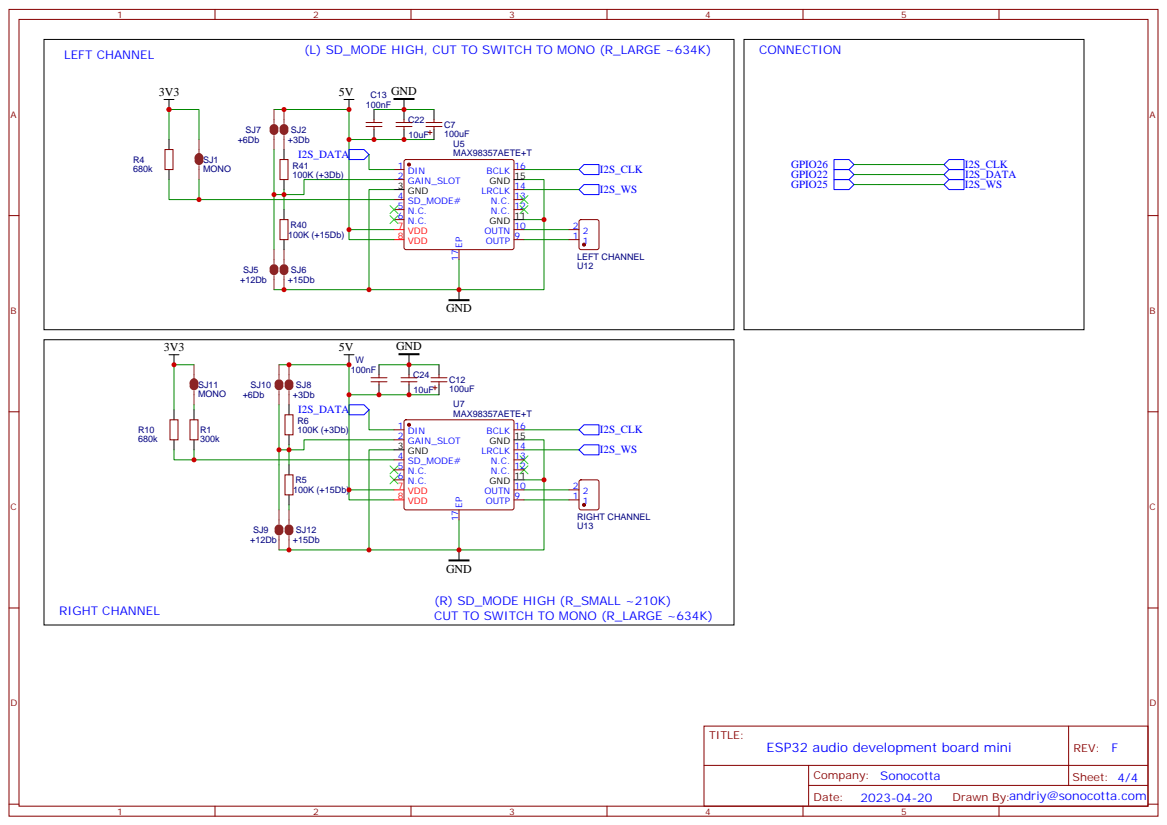
[picture p16: page 4]

(R) SD_MODE HIGH (R_SMALL ~210K)
CUT TO SWITCH TO MONO (R_LARGE ~634K)
