sonocotta/loud-esp/hardware/esp32-audio-dev-mini/loud-esp-mini-rev-e-pcb.pdf

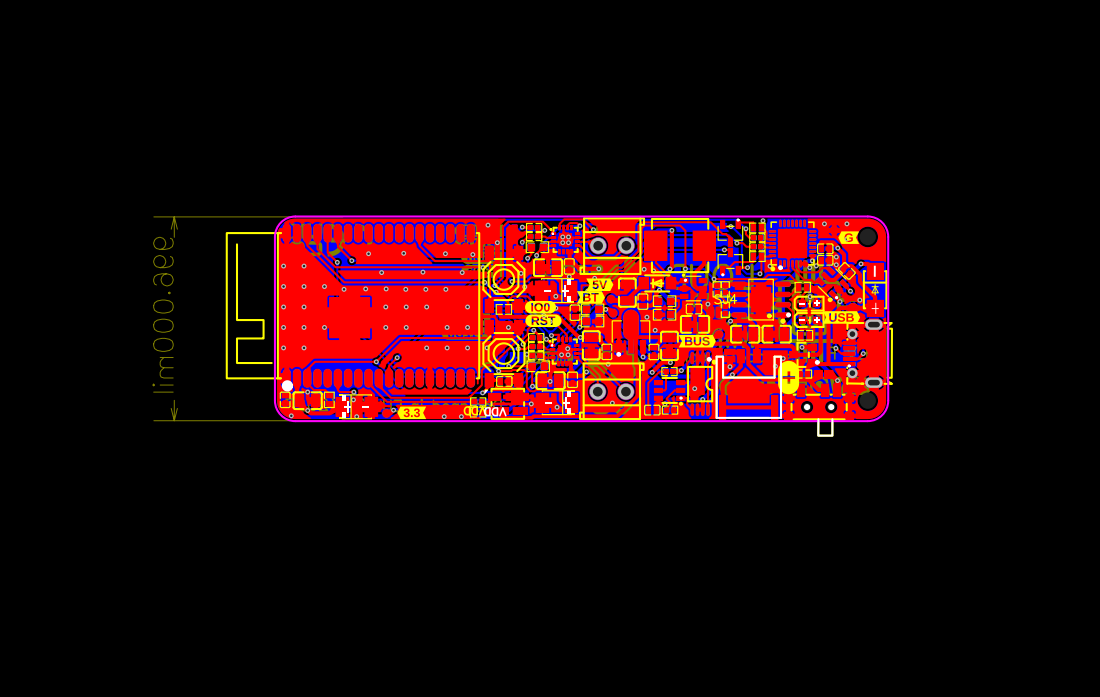
[picture p17: page 1]
