sonocotta/loud-esp/hardware/esp8266-audio-dev/esp8266-audio-board-rev-e.pdf

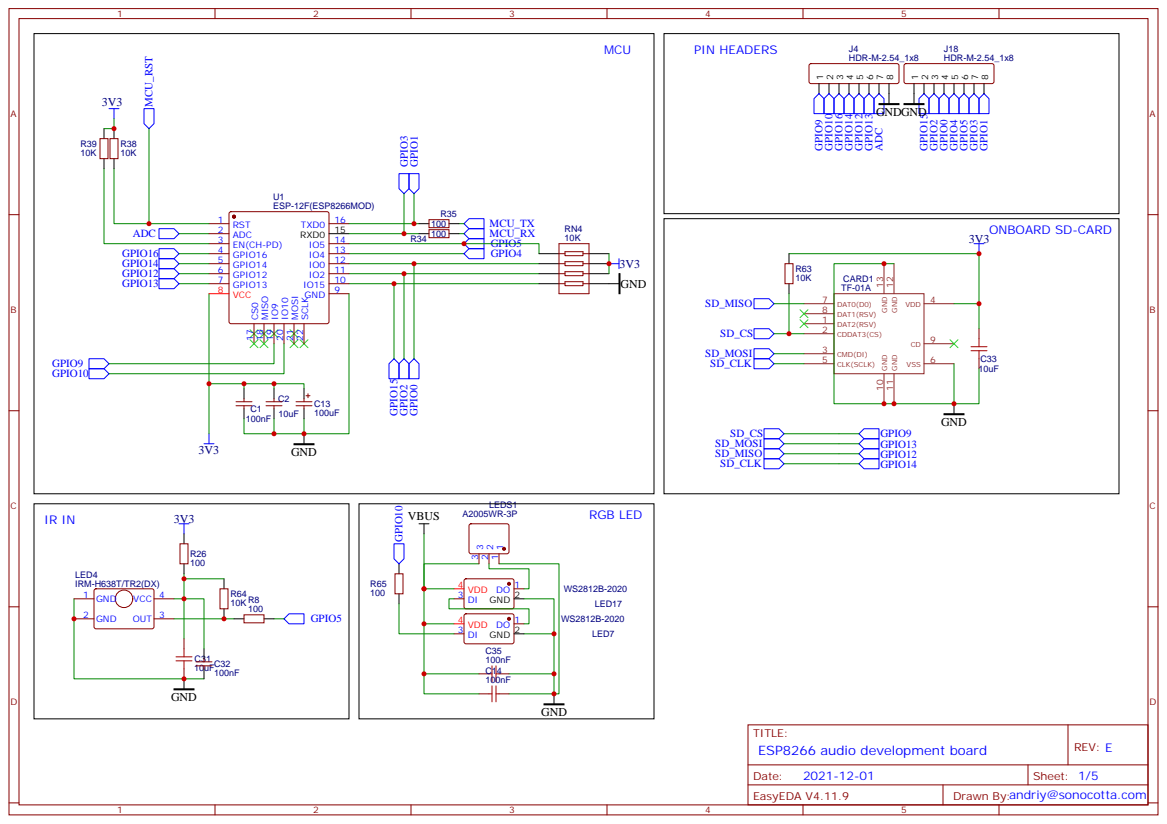
[picture p18: page 1]

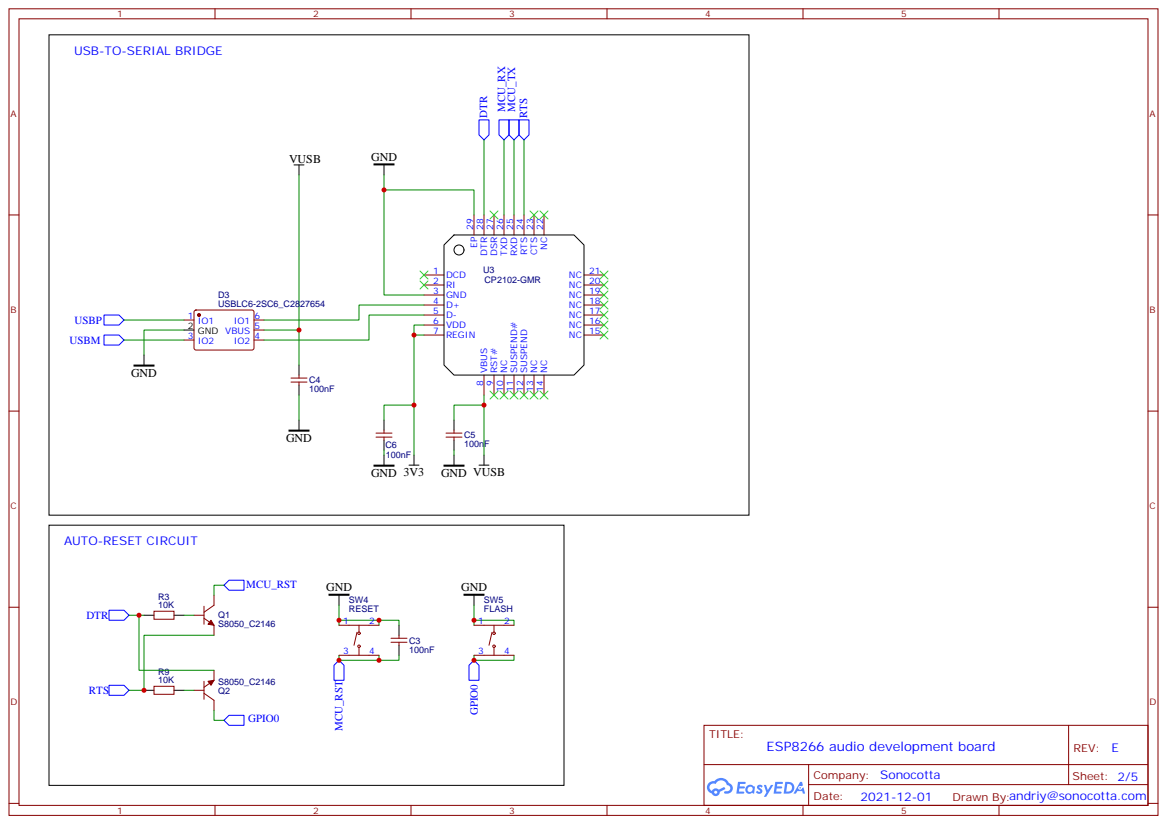
[picture p19: page 2]

USB-TO-SERIAL BRIDGE

NC 22 CTS 23 RTS 24 RXD 25 TXD 26 DSR 27 DTR 28 EP 29

Drawn By:andriy@sonocotta.com

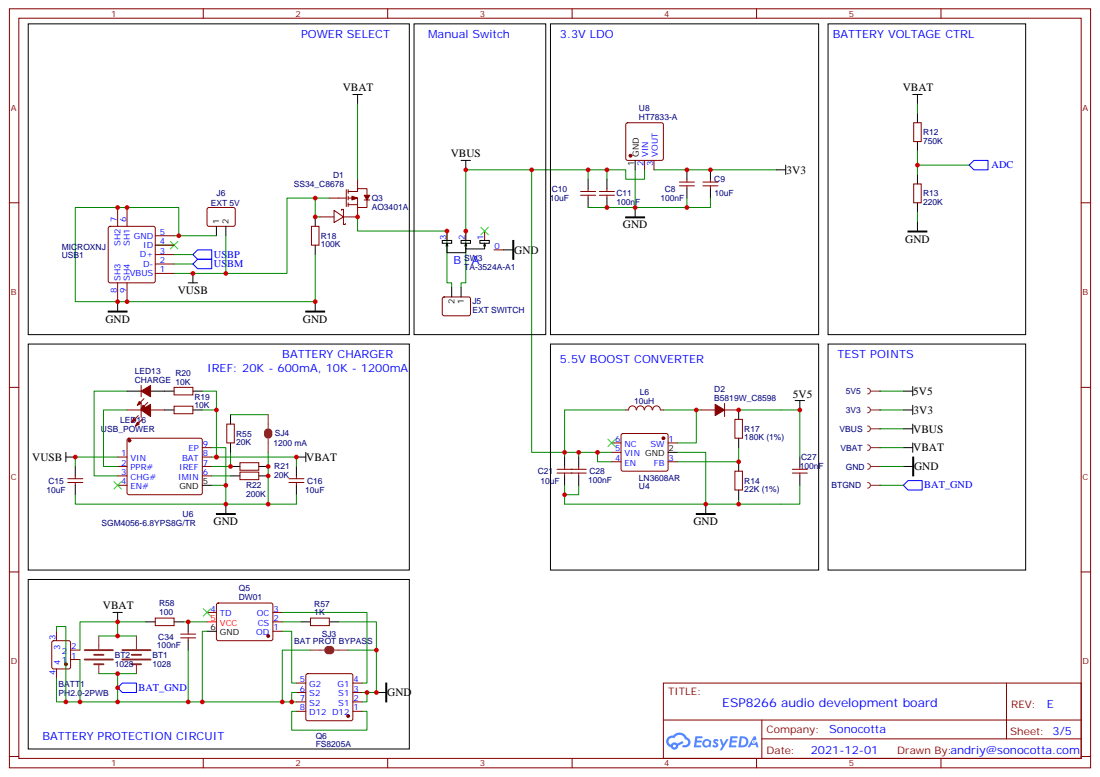
[picture p20: page 3]

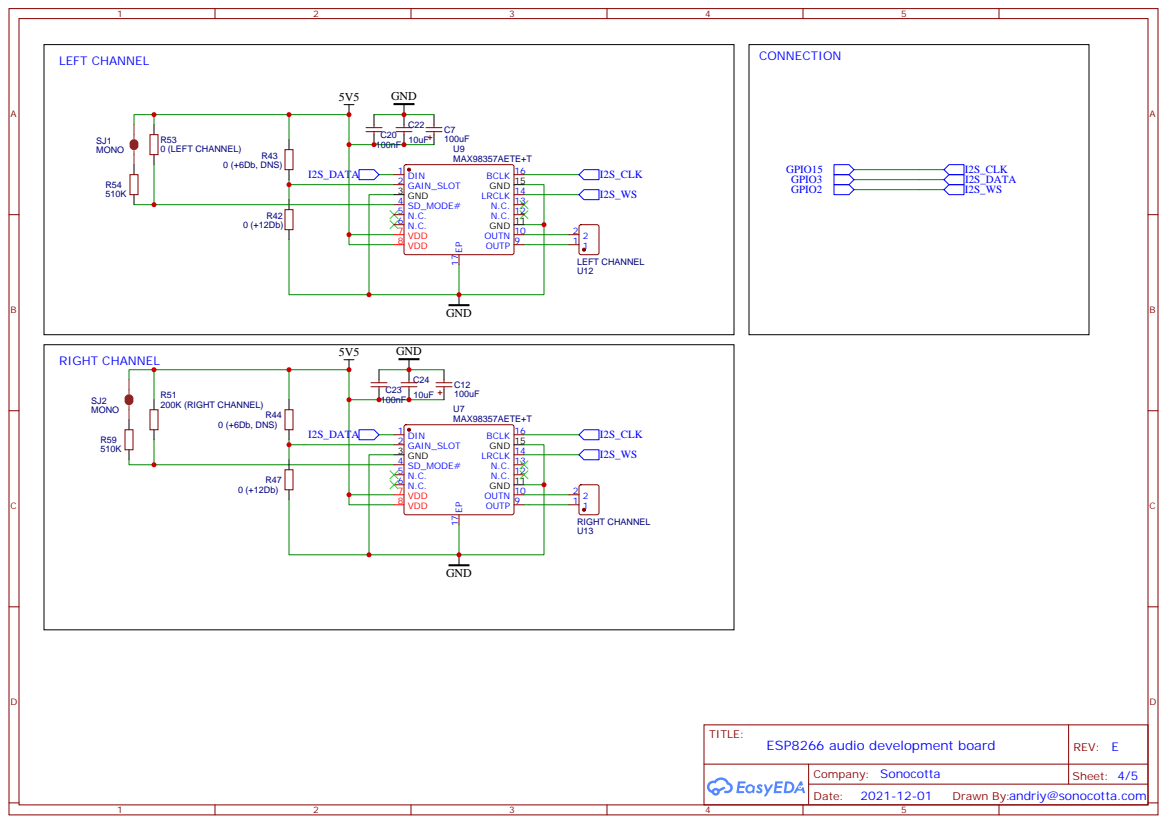
[picture p21: page 4]

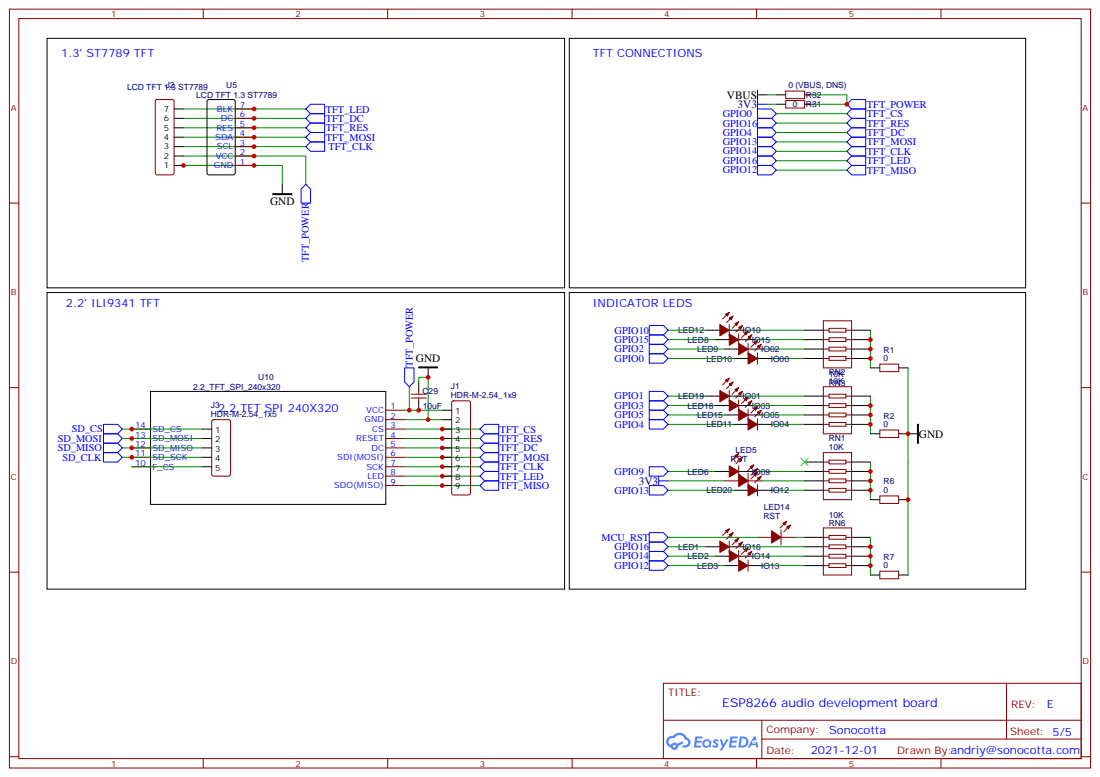
[picture p22: page 5]
