sonocotta/loud-esp/hardware/loud-esp-rfid-edition/rev-g/2506-loud-esp-g-espuino-edition-pcb.pdf

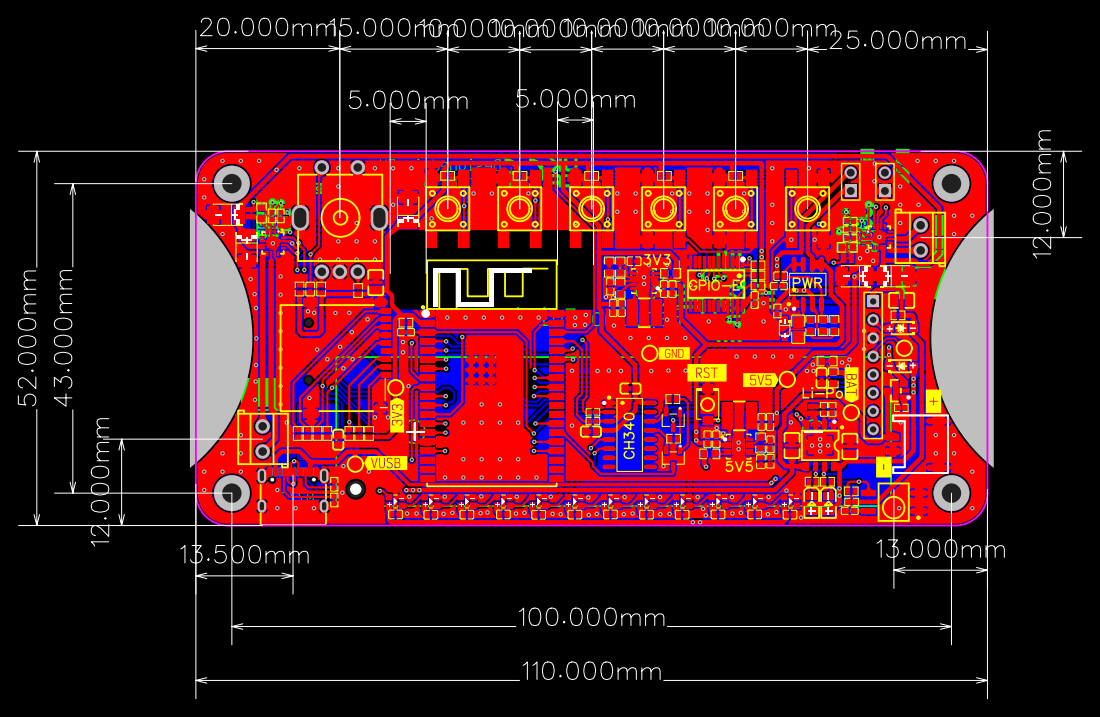
[picture p23: page 1]
