sonocotta/loud-esp/hardware/esp32-audio-dev/rev-h/2504-loud-esp-h-pcb.pdf

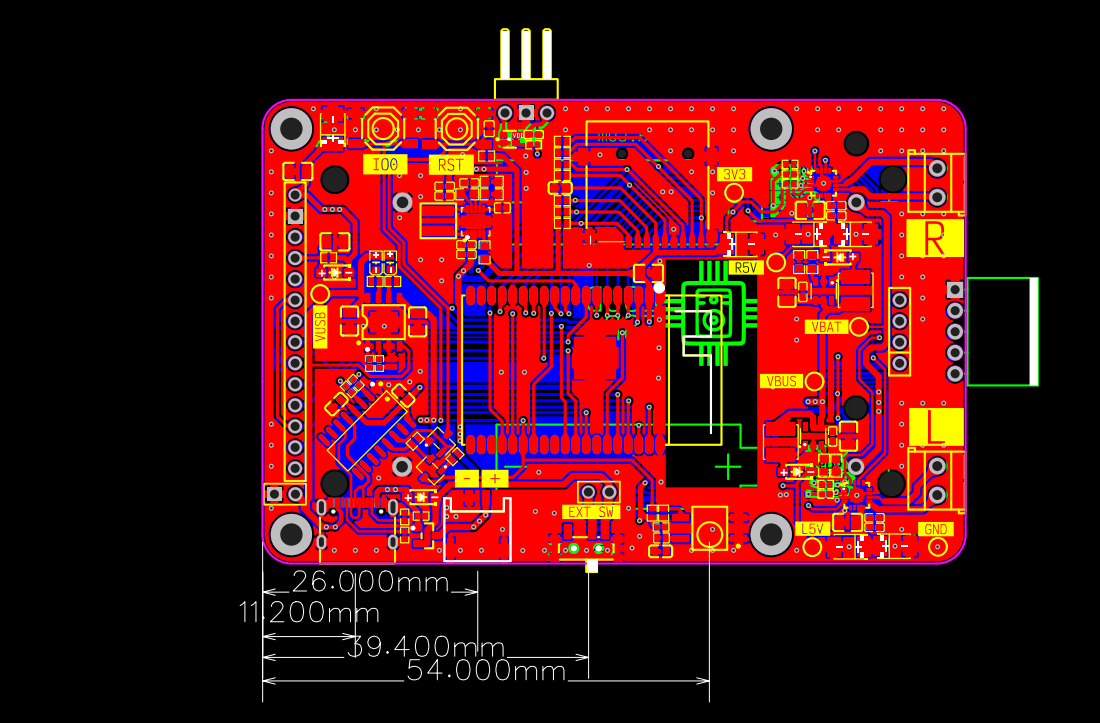
[picture p24: page 1]
