sonocotta/loud-esp/hardware/esp8266-audio-dev/esp8266-audio-board-rev-D.pdf

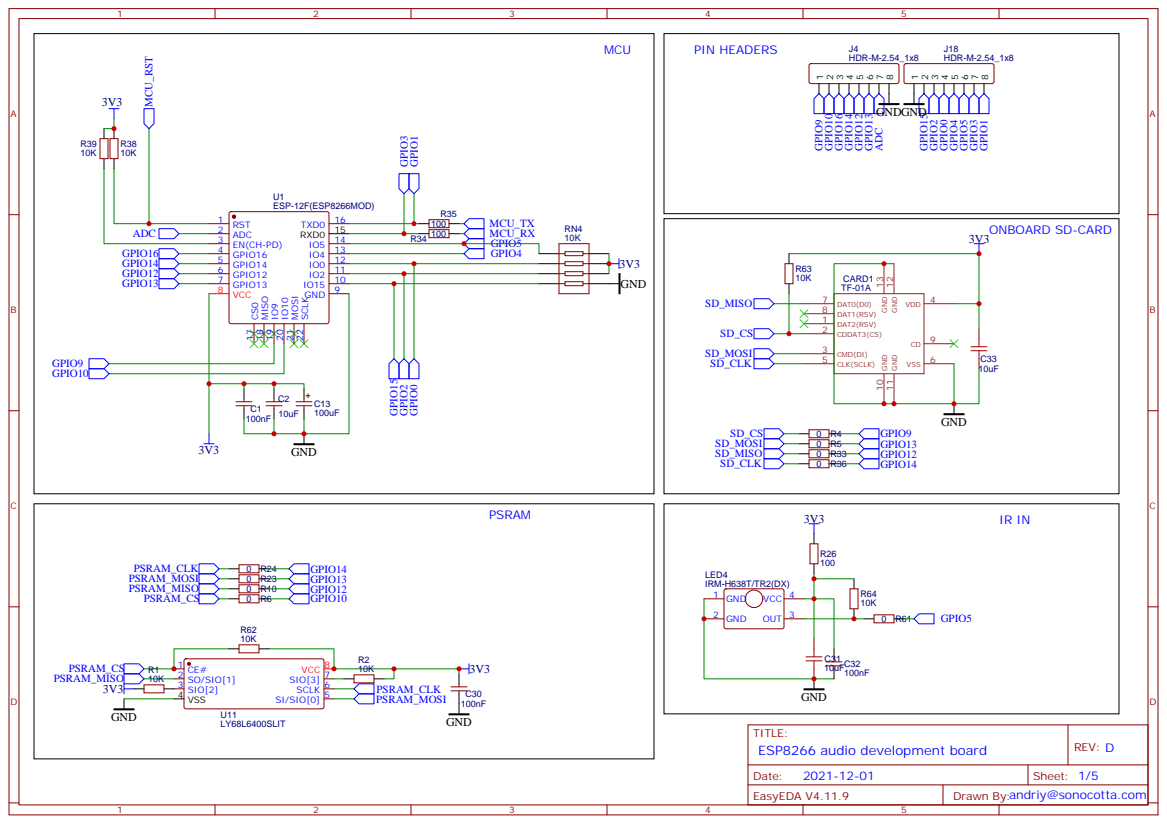
[picture p25: page 1]

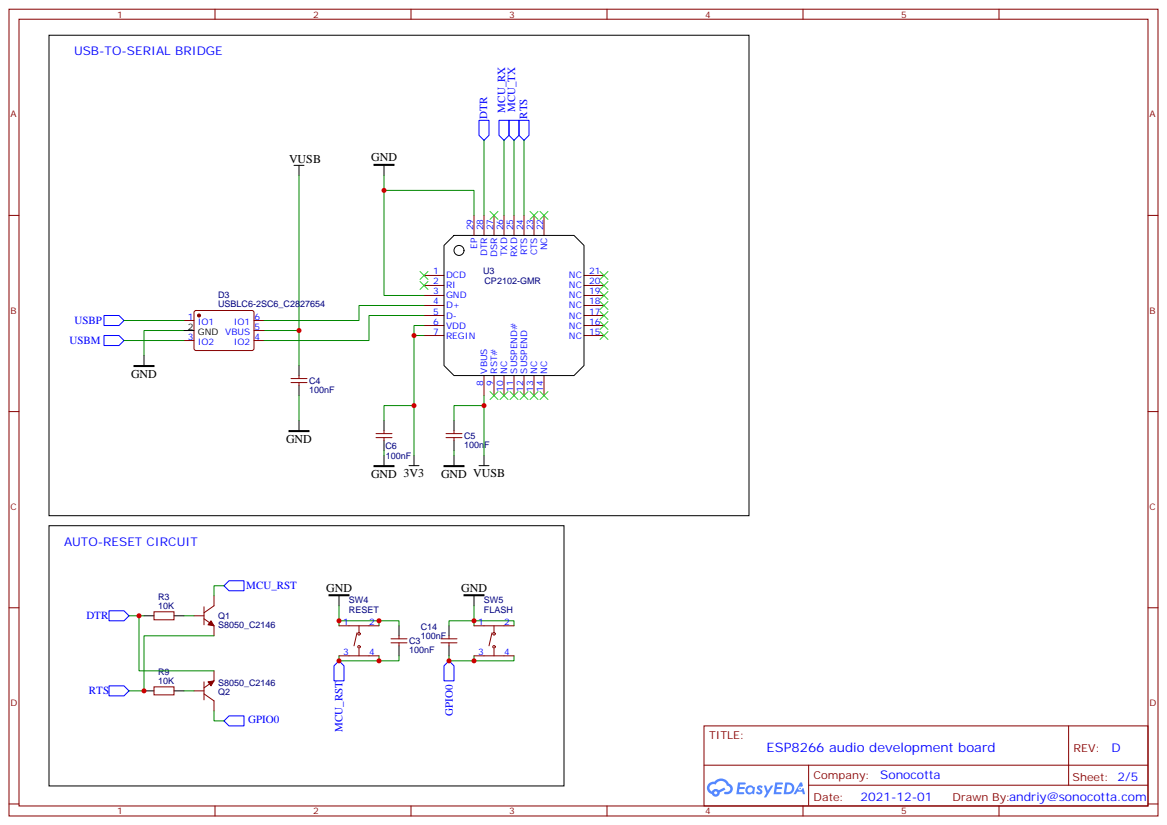
[picture p26: page 2]

USB-TO-SERIAL BRIDGE

NC 22 CTS 23 RTS 24 RXD 25 TXD 26 DSR 27 DTR 28 EP 29

Drawn By:andriy@sonocotta.com

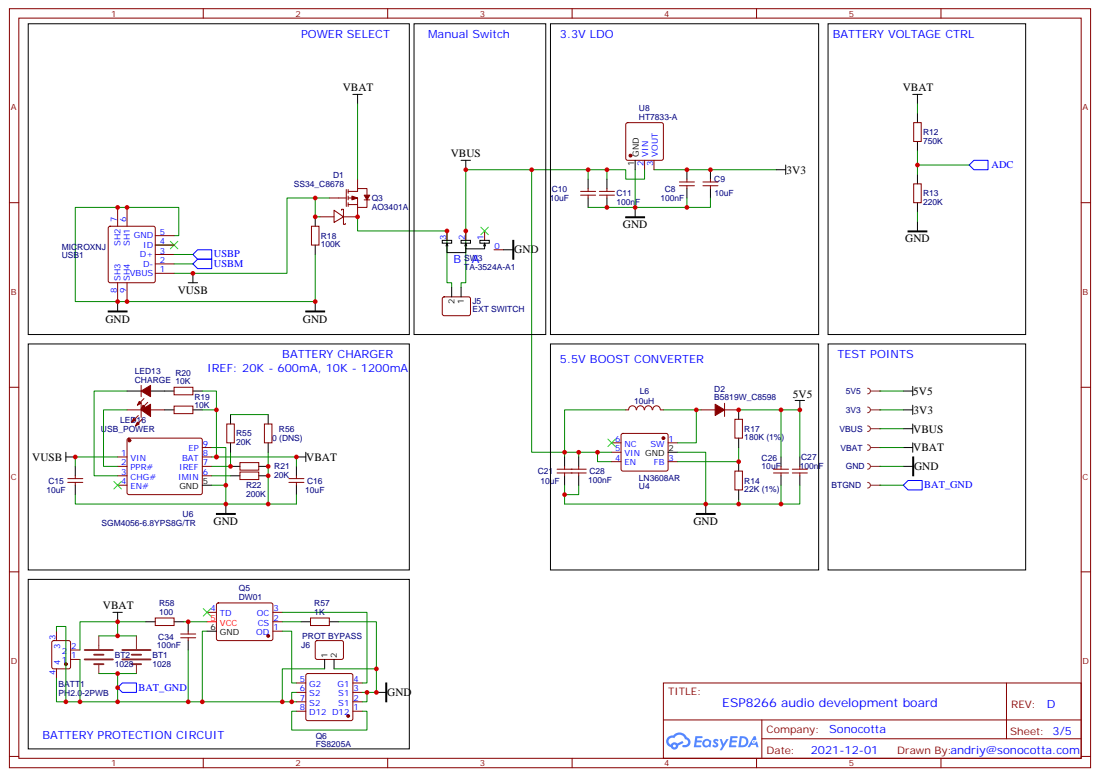
[picture p27: page 3]

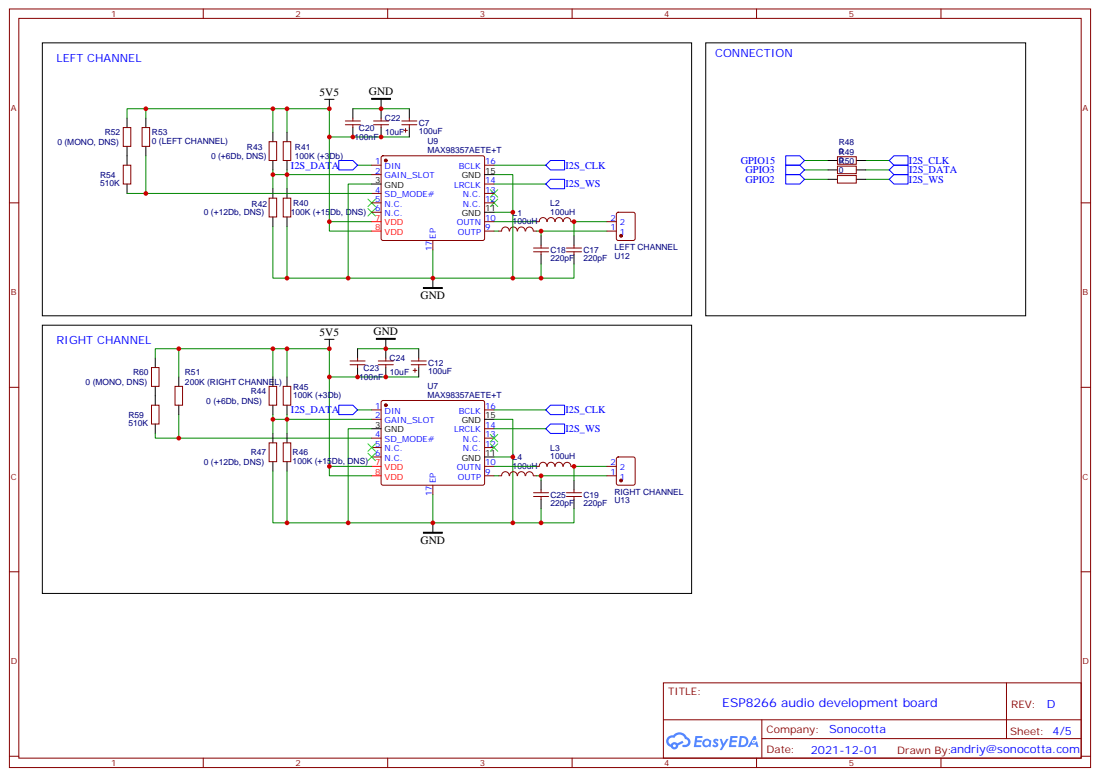
[picture p28: page 4]

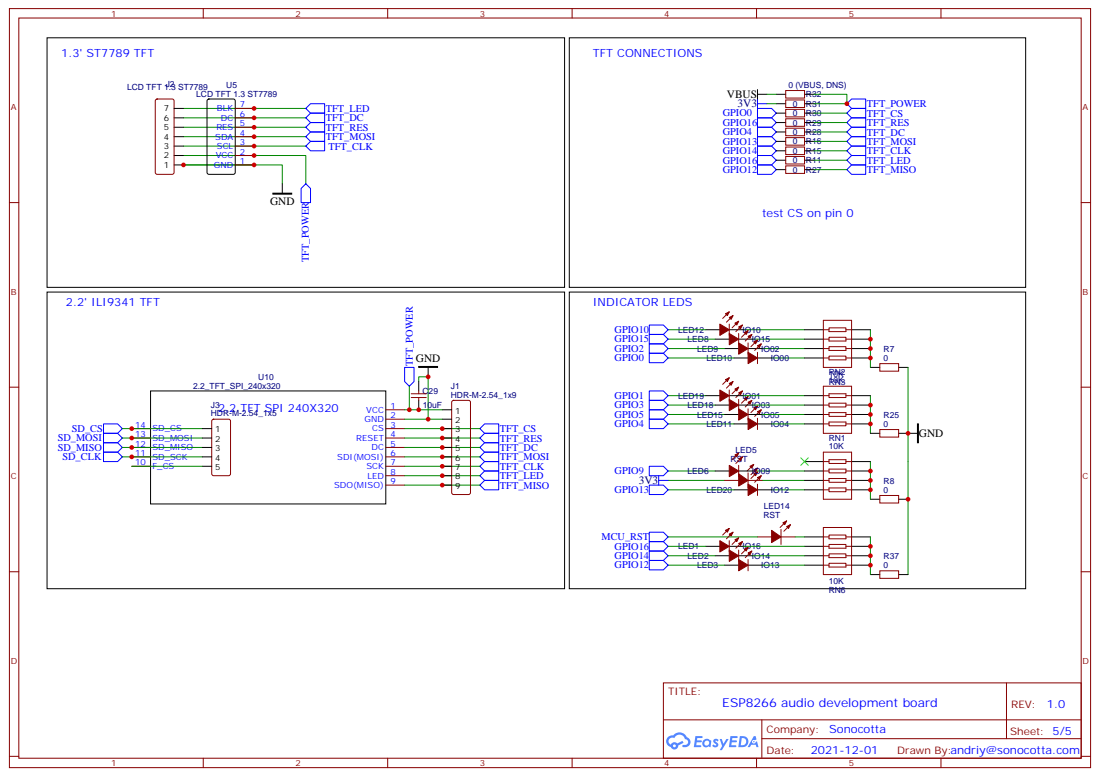
[picture p29: page 5]

test CS on pin 0
