sonocotta/loud-esp/hardware/esp32-audio-dev/rev-f/loud-esp-rev-f-schematic.pdf

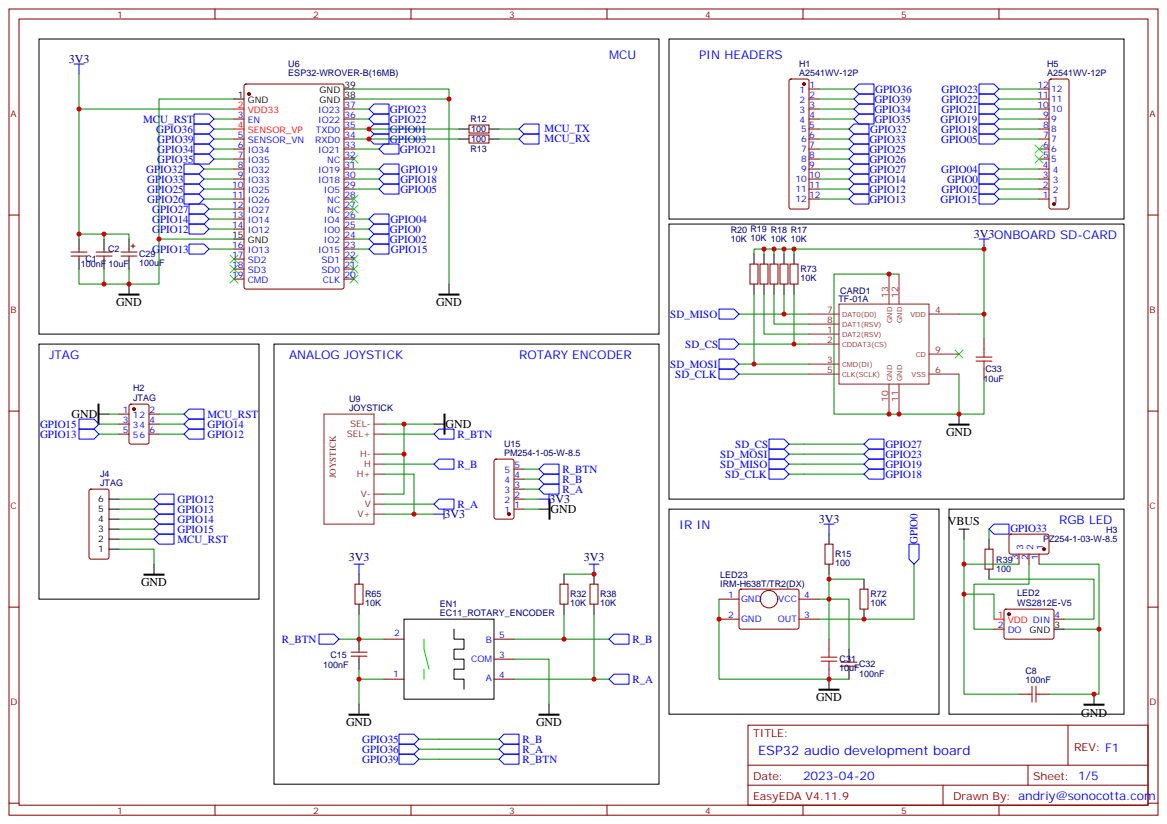
[picture p30: page 1]

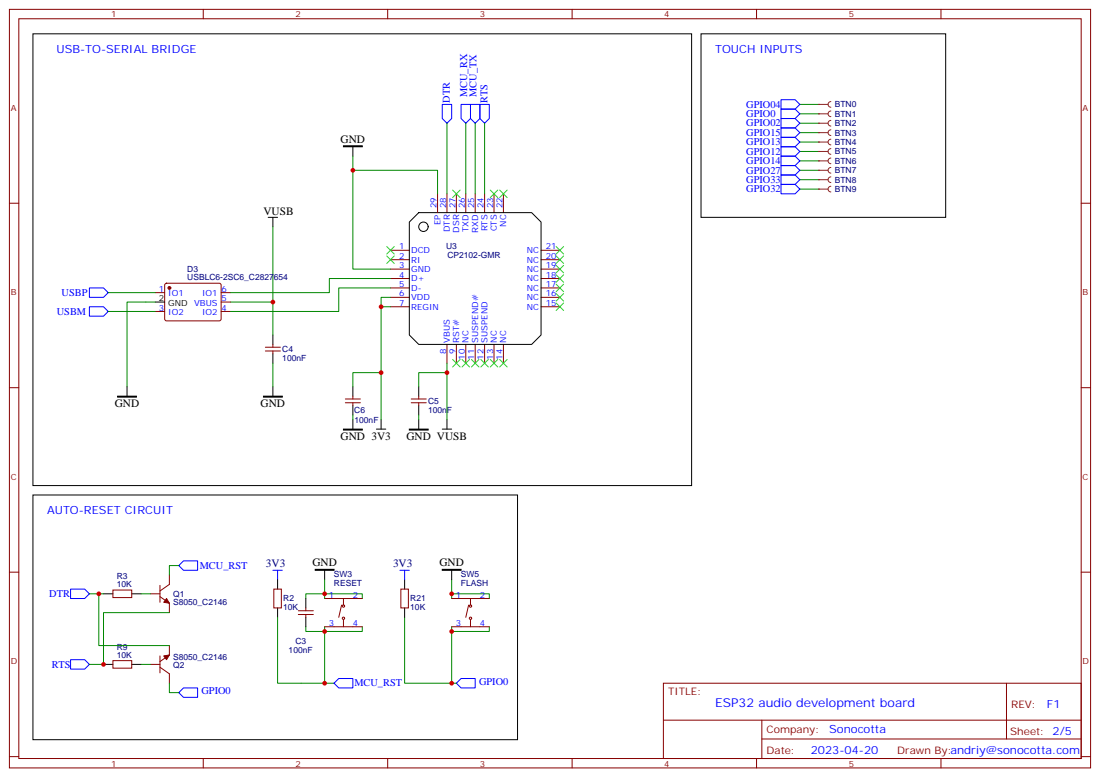
[picture p31: page 2]

USB-TO-SERIAL BRIDGE

NC 22 CTS 23 RTS 24 RXD 25 TXD 26 DSR 27 DTR 28 EP 29

Drawn By:andriy@sonocotta.com

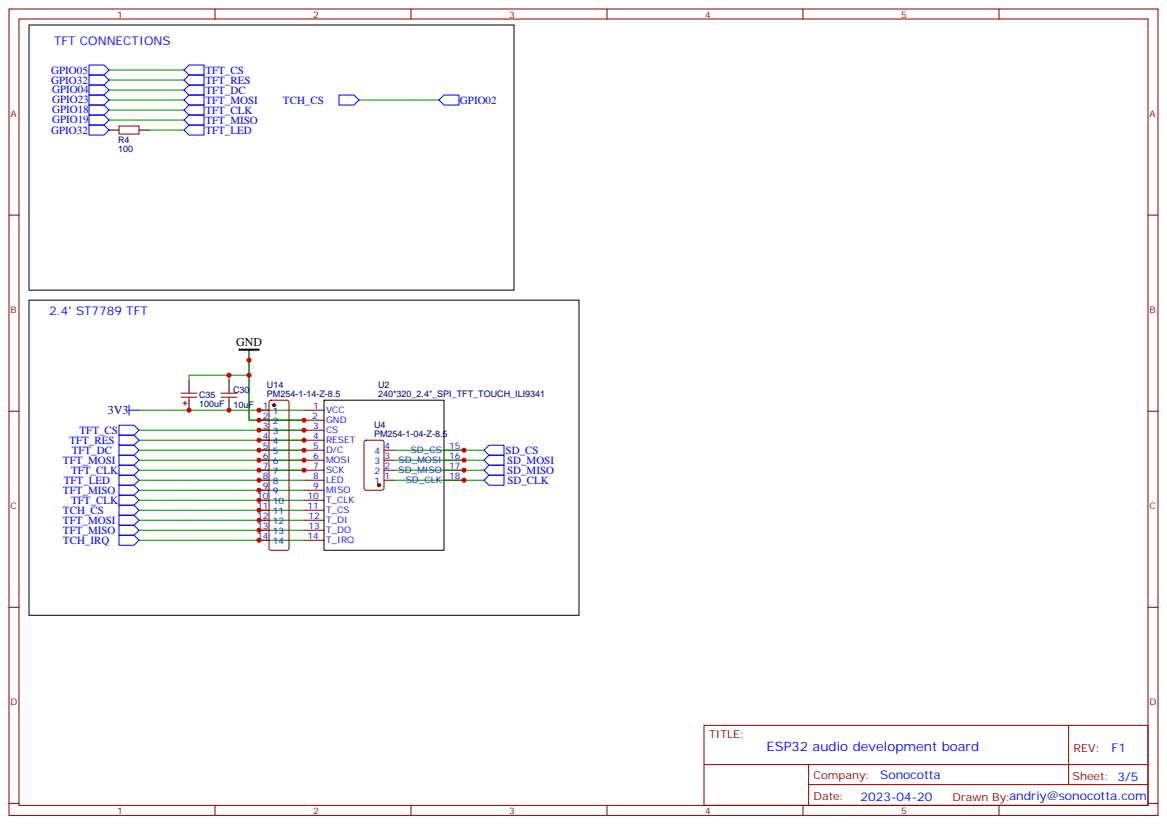
[picture p32: page 3]

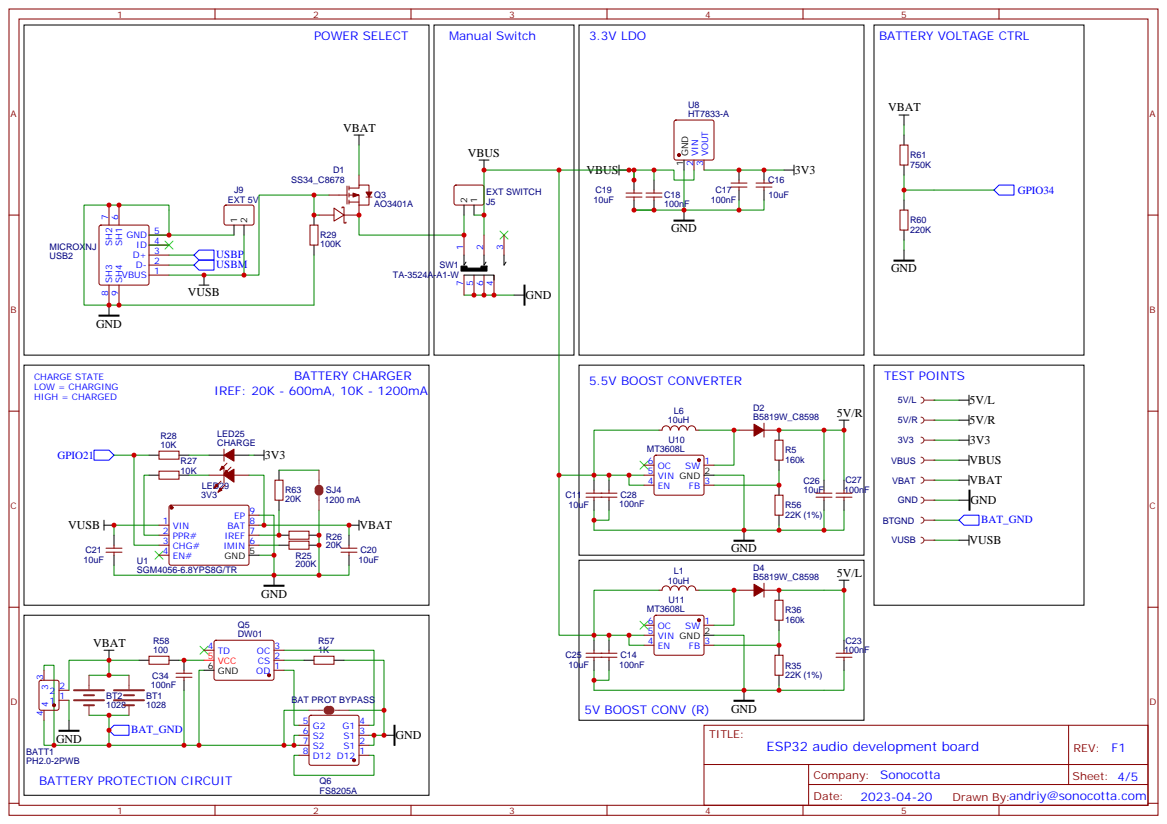
[picture p33: page 4]

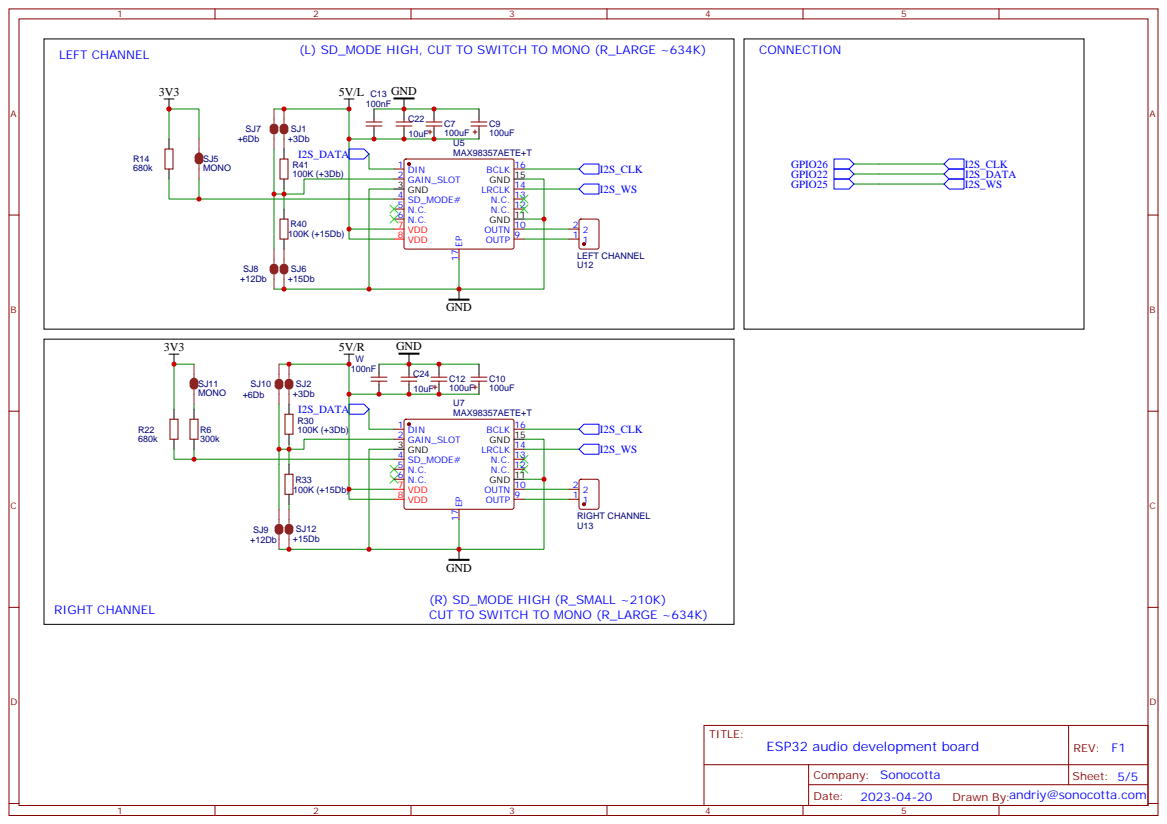
[picture p34: page 5]

(R) SD_MODE HIGH (R_SMALL ~210K)
CUT TO SWITCH TO MONO (R_LARGE ~634K)
