sonocotta/loud-esp/hardware/esp32-audio-dev/rev-f/loud-esp-rev-f-pcb.pdf

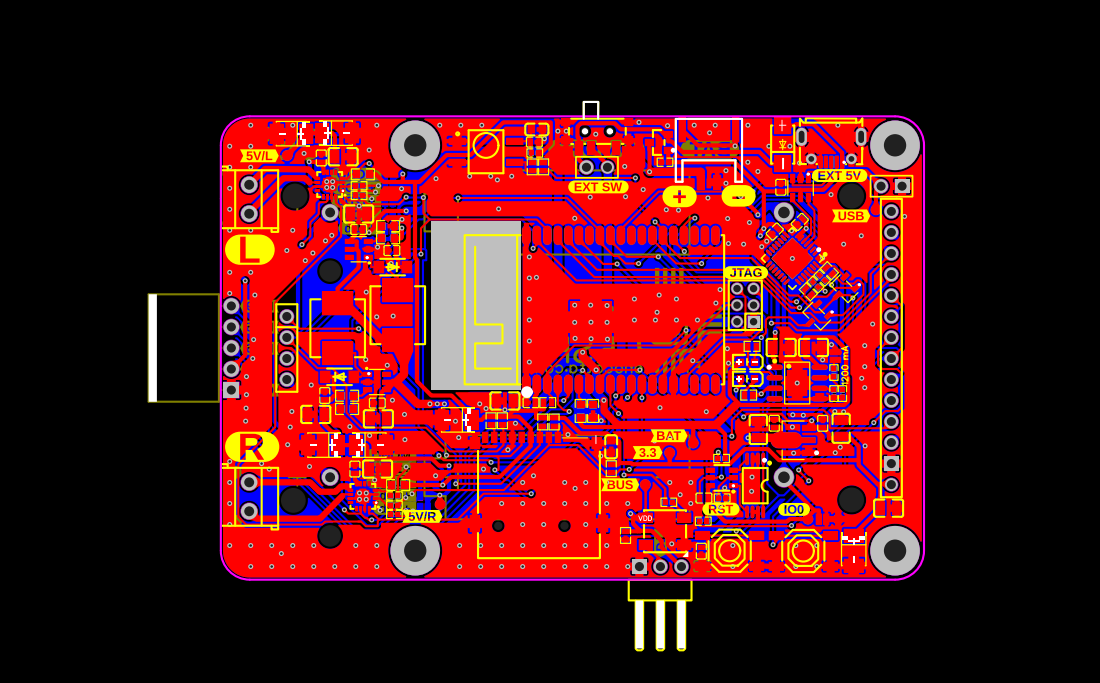
[picture p35: page 1]
