sonocotta/loud-esp/hardware/esp32-audio-dev/rev-d/loud-esp-rev-d-schematic.pdf

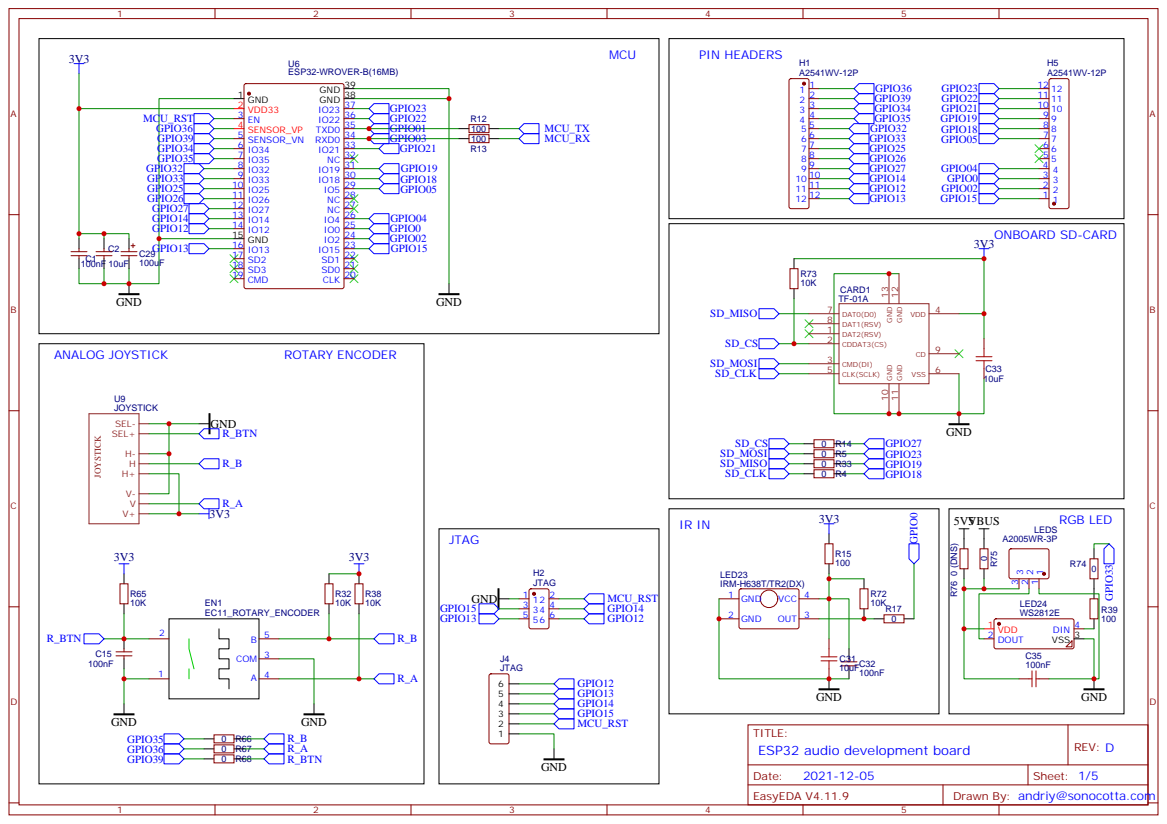
[picture p36: page 1]

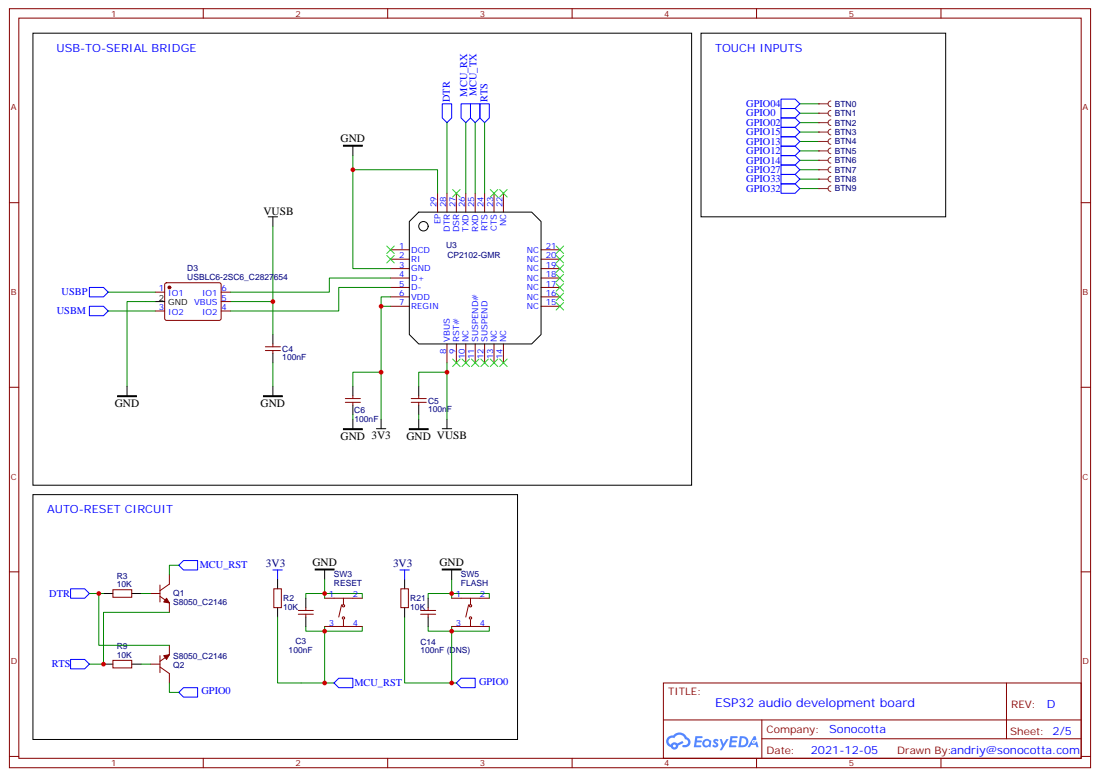
[picture p37: page 2]

USB-TO-SERIAL BRIDGE

NC 22 CTS 23 RTS 24 RXD 25 TXD 26 DSR 27 DTR 28 EP 29

Drawn By:andriy@sonocotta.com

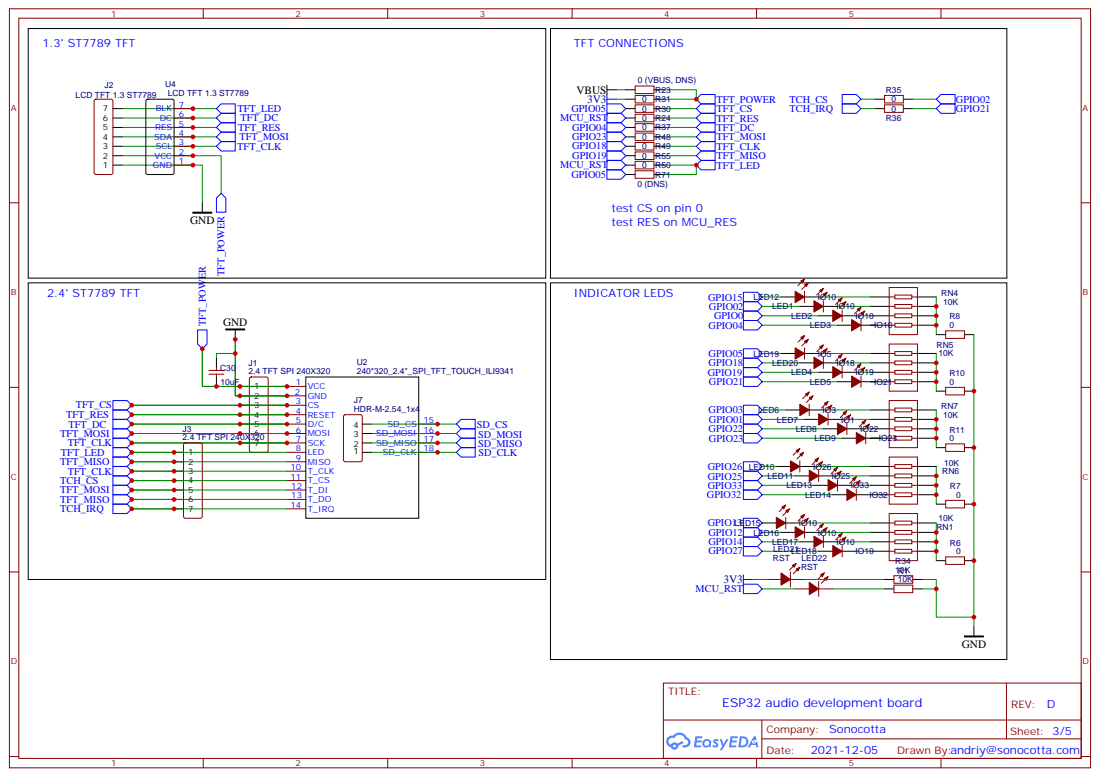
[picture p38: page 3]

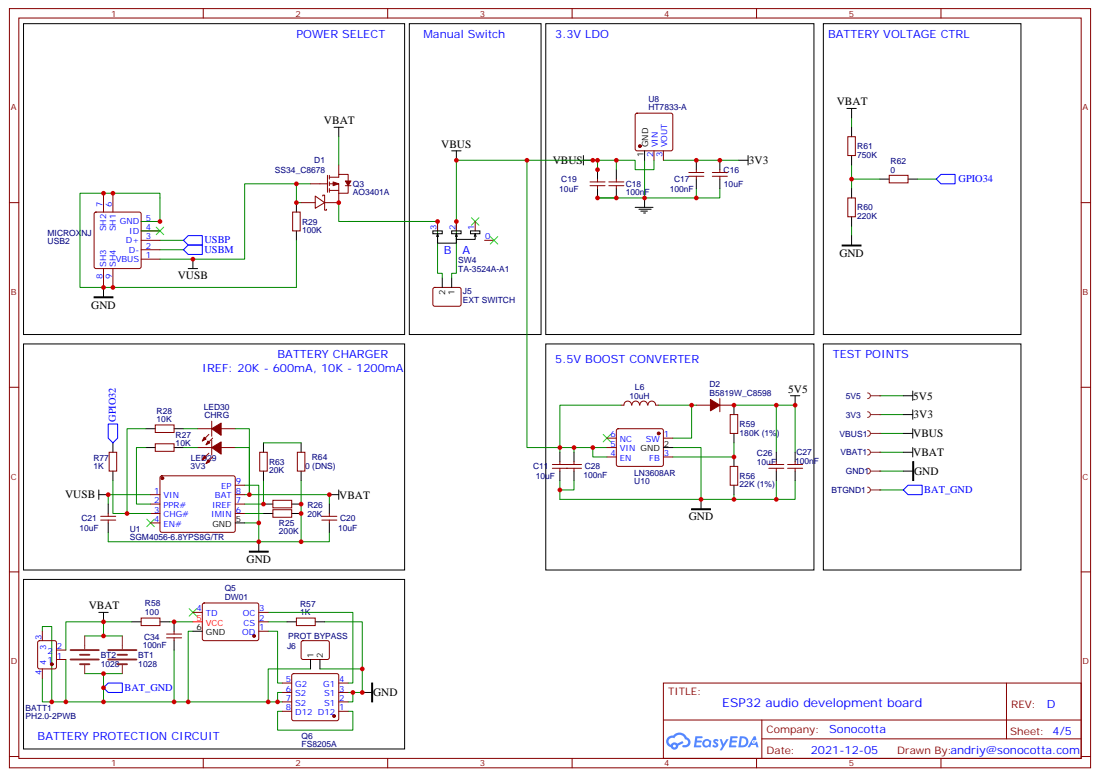
[picture p39: page 4]

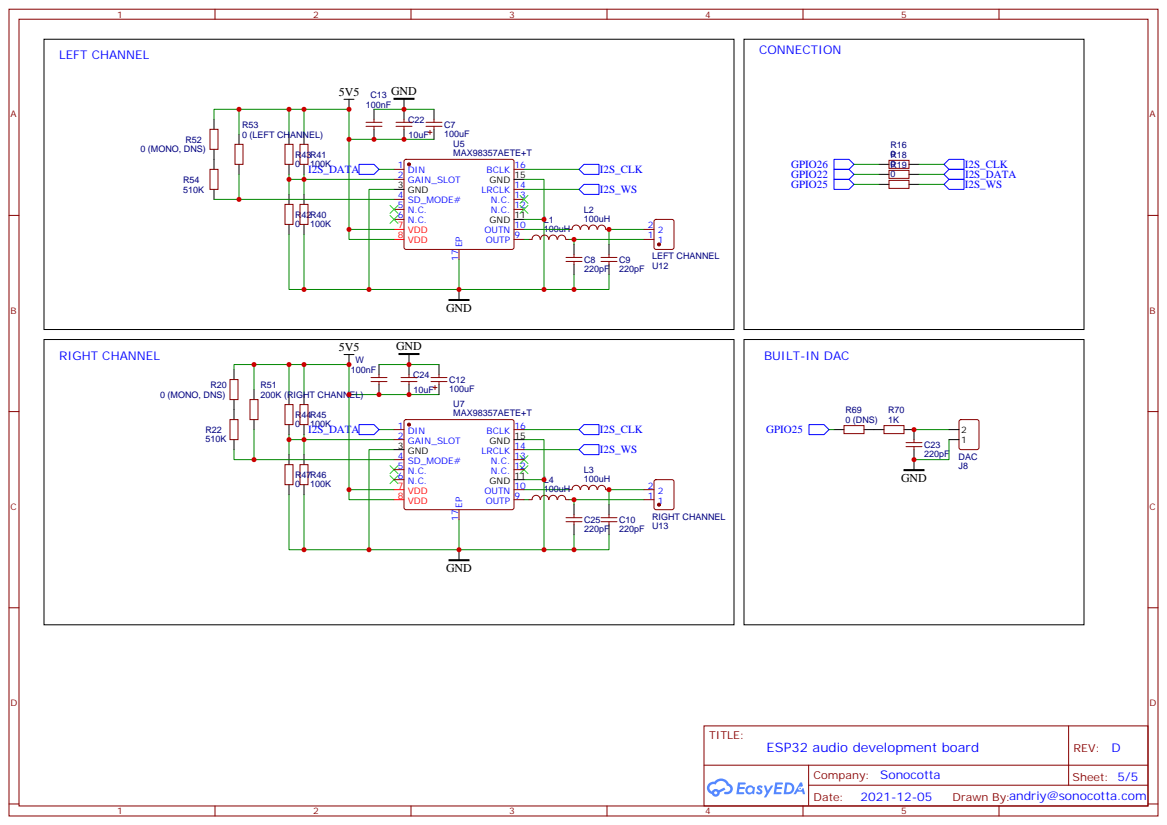
[picture p40: page 5]
