sonocotta/loud-esp/hardware/esp32-audio-dev/rev-e/loud-esp-rev-e-schematic.pdf

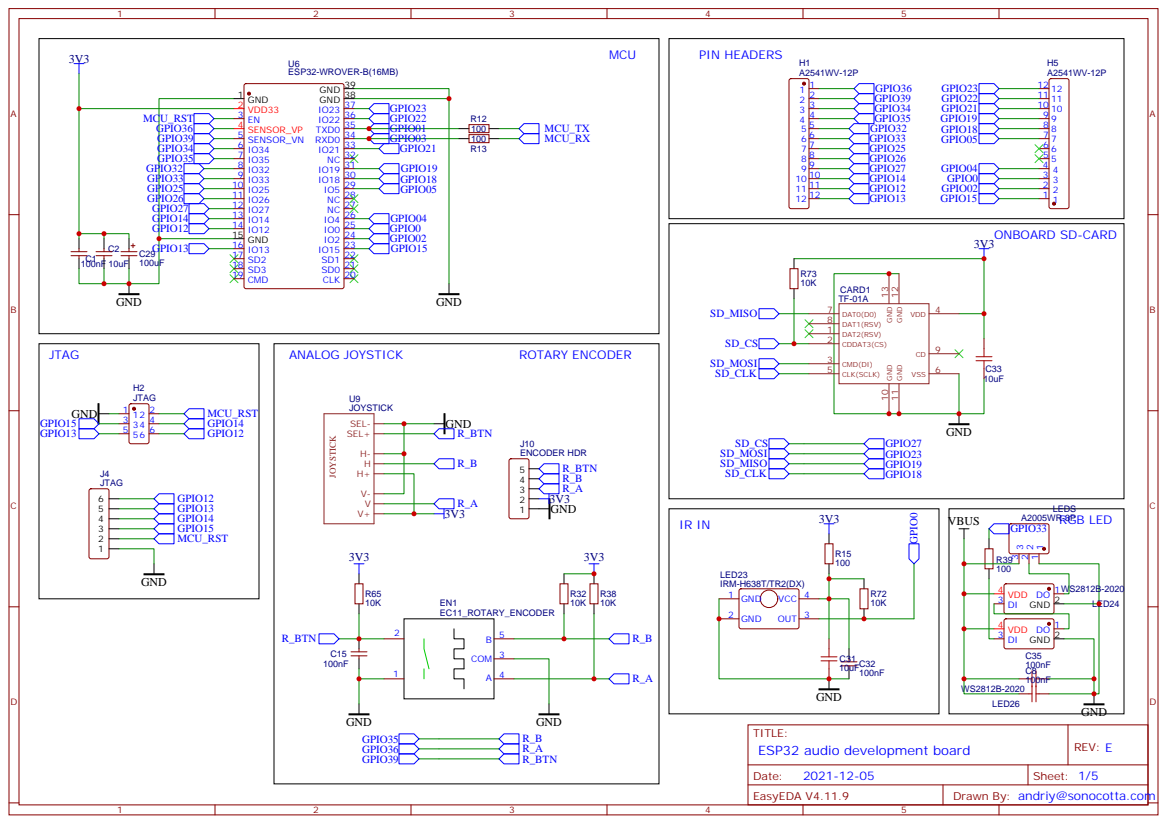
[picture p41: page 1]

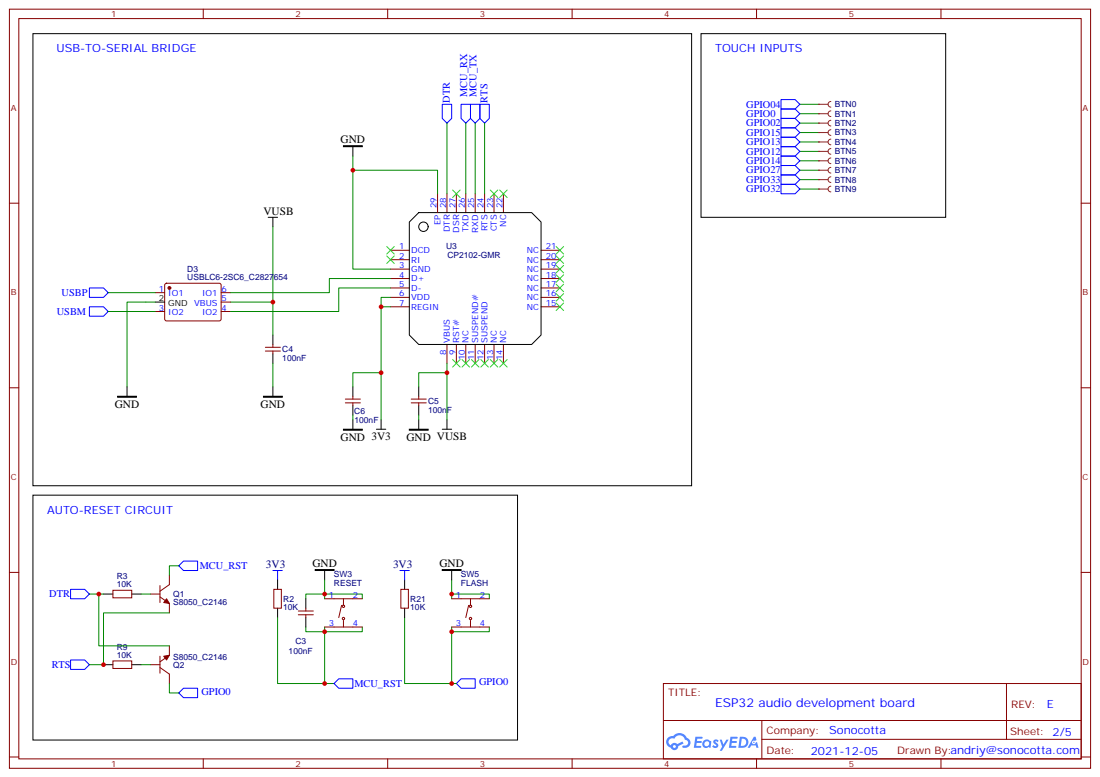
[picture p42: page 2]

USB-TO-SERIAL BRIDGE

NC 22 CTS 23 RTS 24 RXD 25 TXD 26 DSR 27 DTR 28 EP 29

Drawn By:andriy@sonocotta.com

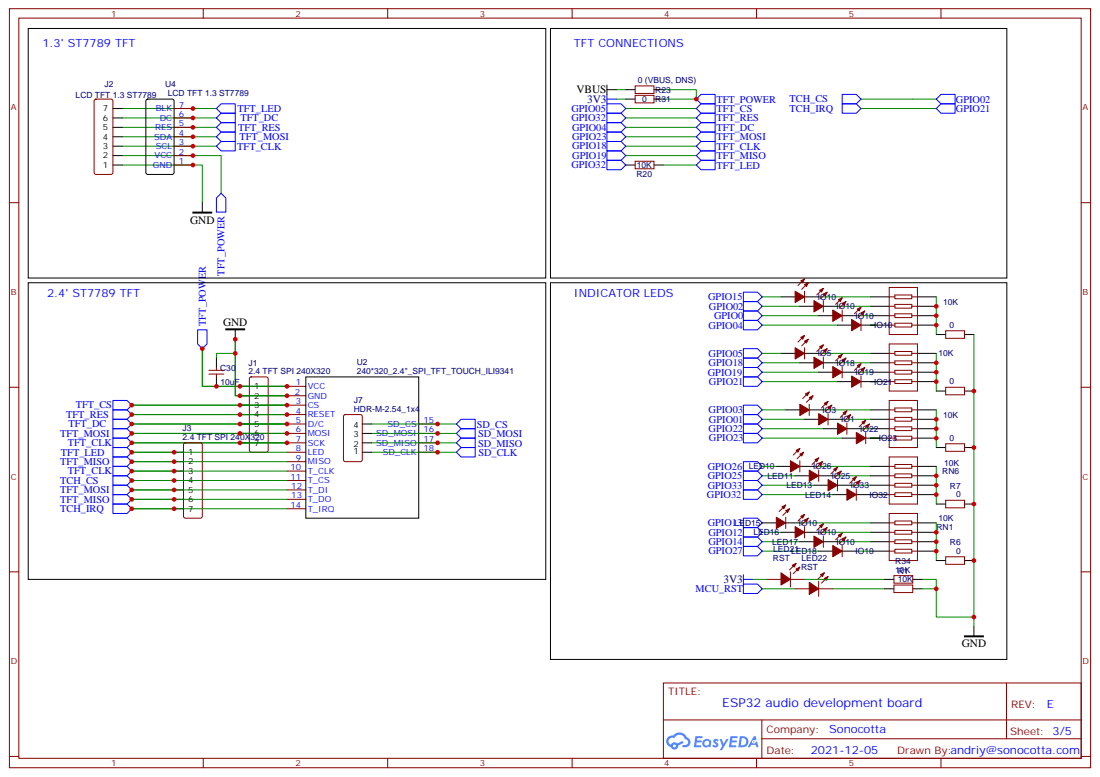
[picture p43: page 3]

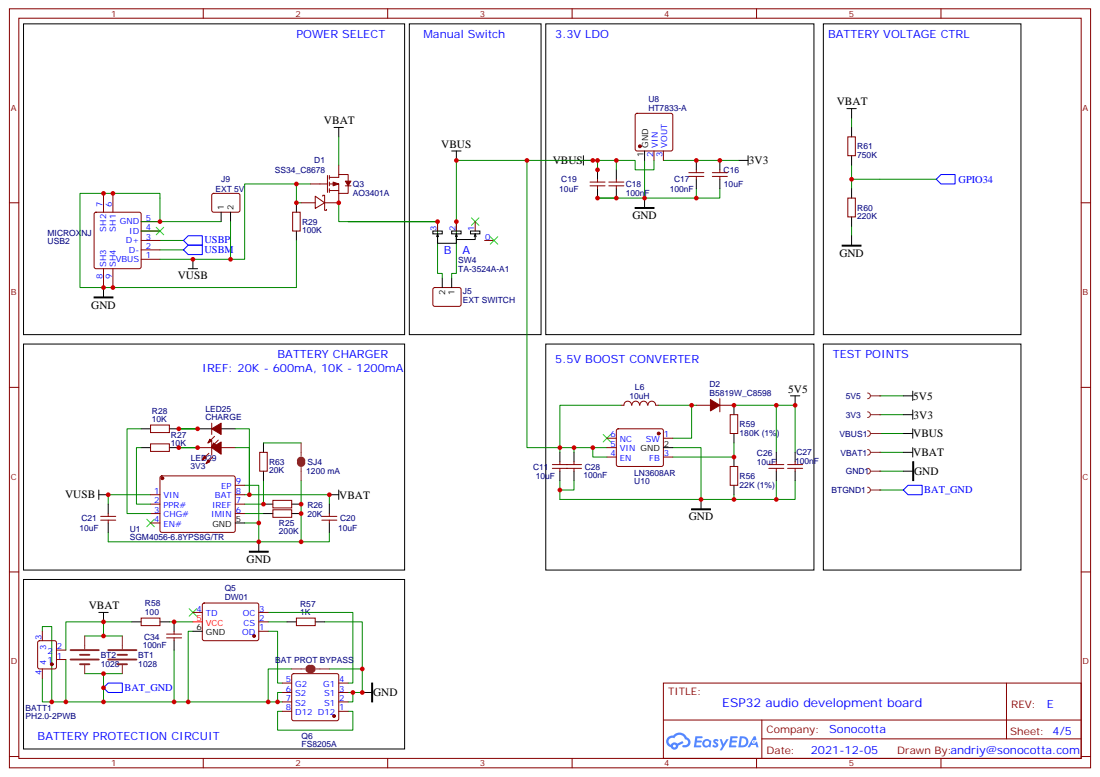
[picture p44: page 4]

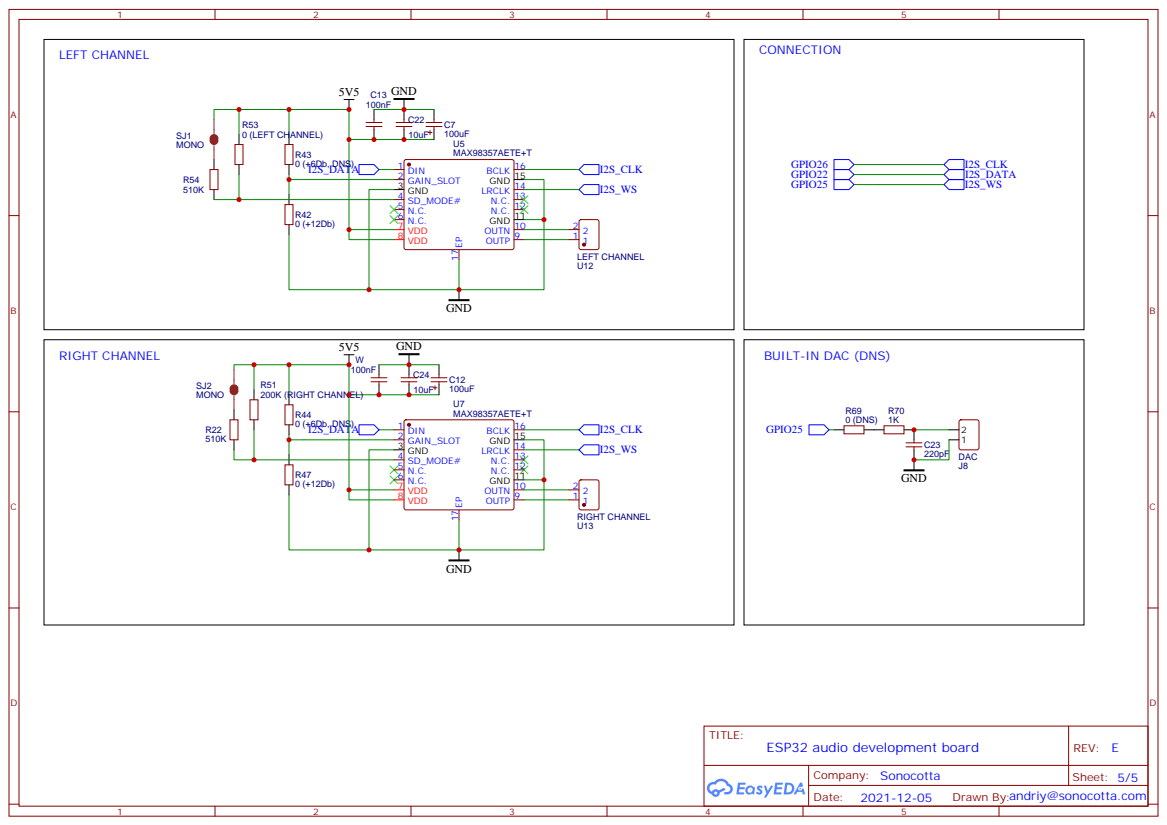
[picture p45: page 5]

BUILT-IN DAC (DNS)
