sonocotta/loud-esp/(list of files, drawings)

Other design files:
hardware/esp32-audio-dev-mini/loud-esp-mini-rev-f-pcb.easyeda.json
hardware/esp32-audio-dev-mini/loud-esp-mini-rev-f-schematic.easyeda.json
hardware/esp32-audio-dev/rev-f/loud-esp-rev-f-pcb.easyeda.json
hardware/esp32-audio-dev/rev-f/loud-esp-rev-f-schematic.easyeda.json
