sonocotta/loud-esp/firmware/test-visual/esp32-demo-ir-volume/src/main.cpp

#include <Arduino.h>
#include <lvgl.h>
#include "lv_demos.h"

#include <Ticker.h>
#define LVGL_TICK_PERIOD 20
Ticker tick;

#include "SPI.h"
#include "TFT_eSPI.h"
TFT_eSPI tft = TFT_eSPI();

// Calibration values
#define TOUCH_MIN_X 236
#define TOUCH_MAX_X 3927
#define TOUCH_MIN_Y 394
#define TOUCH_MAX_Y 3706

static lv_disp_draw_buf_t draw_buf;
static lv_color_t buf[ TFT_HEIGHT * 10 ];

/* Display flushing */
void my_disp_flush( lv_disp_drv_t *disp, const lv_area_t *area, lv_color_t *color_p )
{
    uint32_t w = ( area->x2 - area->x1 + 1 );
    uint32_t h = ( area->y2 - area->y1 + 1 );

    tft.startWrite();
    tft.setAddrWindow( area->x1, area->y1, w, h );
    tft.pushColors( ( uint16_t * )&color_p->full, w * h, true );
    tft.endWrite();

    lv_disp_flush_ready( disp );
}

/*Read the touchpad*/
void my_touchpad_read( lv_indev_drv_t * indev_driver, lv_indev_data_t * data )
{
    uint16_t touchX, touchY;

    bool touched = tft.getTouch( &touchX, &touchY, 600 );

    if( !touched )
    {
        data->state = LV_INDEV_STATE_REL;
    }
    else
    {
        data->state = LV_INDEV_STATE_PR;

        /*Set the coordinates*/
        data->point.x = touchX;
        data->point.y = touchY;

        Serial.print( "Data x " );
        Serial.println( touchX );

        Serial.print( "Data y " );
        Serial.println( touchY );
    }
}

void setup()
{
    Serial.begin( SERIAL_BAUD ); /* prepare for possible serial debug */

    String LVGL_Arduino = "Hello Arduino! ";
    LVGL_Arduino += String('V') + lv_version_major() + "." + lv_version_minor() + "." + lv_version_patch();

    Serial.println( LVGL_Arduino );
    Serial.println( "I am LVGL_Arduino" );

    lv_init();

#if LV_USE_LOG != 0
    lv_log_register_print_cb( [](const char * buf)
    {
        Serial.printf(buf);
        Serial.flush();
    }); /* register print function for debugging */
#endif

    tft.begin();          /* TFT init */
    tft.setRotation( TFT_ROTATION ); /* Landscape orientation, flipped */

    /*Set the touchscreen calibration data,
     the actual data for your display can be acquired using
     the Generic -> Touch_calibrate example from the TFT_eSPI library*/
    uint16_t calData[5] = { TOUCH_MIN_X, TOUCH_MAX_X, TOUCH_MIN_Y, TOUCH_MAX_Y, TFT_ROTATION };
    tft.setTouch( calData );

    lv_disp_draw_buf_init( &draw_buf, buf, NULL, tft.width() * 10 );

    /*Initialize the display*/
    static lv_disp_drv_t disp_drv;
    lv_disp_drv_init( &disp_drv );

    /*Change the following line to your display resolution*/
    disp_drv.hor_res = tft.width();
    disp_drv.ver_res = tft.height();
    disp_drv.flush_cb = my_disp_flush;
    disp_drv.draw_buf = &draw_buf;
    lv_disp_drv_register( &disp_drv );

    /*Initialize the (dummy) input device driver*/
    static lv_indev_drv_t indev_drv;
    lv_indev_drv_init( &indev_drv );
    indev_drv.type = LV_INDEV_TYPE_POINTER;
    indev_drv.read_cb = my_touchpad_read;
    lv_indev_drv_register( &indev_drv );

    tick.attach_ms(LVGL_TICK_PERIOD, [](void){ lv_tick_inc(LVGL_TICK_PERIOD); });

#if 0
    /* Create simple label */
    lv_obj_t *label = lv_label_create( lv_scr_act() );
    lv_label_set_text( label, LVGL_Arduino.c_str() );
    lv_obj_align( label, LV_ALIGN_CENTER, 0, 0 );
#else
    lv_demo_widgets();            // OK
#endif
    Serial.println( "Setup done" );
}


void loop()
{
    lv_timer_handler(); /* let the GUI do its work */
    delay( 5 );
}
