sonocotta/loud-esp/firmware/test-visual/esp32-demo-vu-meters/src/globals.h

#pragma once

// // basics
// int16_t moduleType = 0;
// int16_t rcType = 0;

// //added by Mark Donners
// // bool InputSelect=AUDIO_INPUT_LINEIN; // Choose AUDIO_INPUT_MIC or AUDIO_INPUT_LINEIN

bool calibrate = false;
// bool lockScreenUpdate = false;
// bool flipScreen = false;
bool showCalibrationFrame = false;



// bool ANALOG_MenuActive = false;
// bool FFT_MenuActive = false;
// bool GONIO_MenuActive = false;

// float GONIO_dBLow = -40.0f;
// float dBHigh = 6.1f;
// float dBRMSL = -100.0f;
// float dBRMSR = -100.0f;
// float dBPPML = -100.0f;
// float dBPPMR = -100.0f;

// // remotecontrol
// uint32_t IR_Up = 2011287606;
// uint32_t IR_Left = 2011238454;
// uint32_t IR_Right = 2011291702;
// uint32_t IR_Down = 2011279414;
// uint32_t IR_PlayStop = 2011242550;
// uint32_t IR_Menu = 2011250742;

// // gonio
// uint16_t GONIO_SampleBlocks = 8;
// bool GONIO_PeakHold = false;


// bool GONIO_ShowA700Frame = false;


// uint16_t GONIO_Offset = 0;

// // calibration
// int RMSCorrectionLeft = 0;
// int RMSCorrectionRight = 0;
// int PPMCorrectionLeft = 0;
// int PPMCorrectionRight = 0;


// uint16_t GONIO_Samples = 0;
// int16_t GONIO_WorkMode = 1;
// uint16_t GONIO_BarMode = 0;  // 0=peak, 1=vu
// int16_t GONIO_DrawMode = 0; //0=pixel, 1=lines
// bool GONIO_ShowSamplesCount = true;
// bool GONIO_SwapX = true;
// bool GONIO_SwapY = true;


// float GONIO_PeakAttenuation = 0.0f;



// uint16_t GONIO_VUBarAttack = 16;
// uint16_t GONIO_VUBarRelease = 2;
// uint16_t GONIO_PEAKBarAttack = 16;
// uint16_t GONIO_PEAKBarRelease = 2;
// uint16_t GONIO_VUPeakHoldTime = 50;
// uint16_t GONIO_PEAKPeakHoldTime = 50;
// uint16_t GONIO_VUPeakRelease = 2;
// uint16_t GONIO_PEAKPeakRelease = 2;


// uint16_t GONIO_PeakHeight = 5;
// uint16_t GONIO_SegmentHeight = 1;

//                    // DarkGray
// uint16_t GONIO_DisplayBackColor = 0;                      // Black
// uint16_t GONIO_LRColor = 0xF7BE;                          // WhiteSmoke
// uint16_t GONIO_HeaderForeColor = 0xAD55;                  // DarkGray
// uint16_t GONIO_ScaleForeColor = 0xBDF7;                   // Gray
// uint16_t GONIO_MarkerColor = 0xFF9C;                      // Linen
// uint16_t GONIO_PeakColor = 0xFEA0;                        // Gold
// uint16_t GONIO_BarColorNormal = 0x1C9F;                   // DodgerBlue
// uint16_t GONIO_BarColorMid = 0xFD20;                      // Orange
// uint16_t GONIO_BarColorOver = 0xF800;                     // Red
// uint16_t GONIO_BarsBackColor = 0x2104;                    // 32,32,32
// uint16_t GONIO_GoniometerColor = 0xBFE0;                  // Lime 
// uint16_t GONIO_CorrelationTextColor = 0xFEA0;             // Gold
// uint16_t GONIO_CorrelationMinusColor = 0xF800;            // Red
// uint16_t GONIO_CorrelationNullColor = 0xFEA0;             // Gold
// uint16_t GONIO_CorrelationPlusColor = 0x3666;             // LimeGreen 
// uint16_t GONIO_CorrelationBackgroundColor = 0x2104;       // 32,32,32
// uint16_t GONIO_CorrelationMarkerColor = 0x6B4D;           // DimGray
// uint16_t GONIO_CorrelationHoldColor = 0x6B4D;             // DimGray
// uint16_t GONIO_CorrelationHoldBackgroundColor = 0x2104;   // 32,32,32
// uint16_t GONIO_CrossColor = 0x7412;                       // SlateGray


// /// <summary>
// /// goniometer menu
// /// </summary>
// const char* strMenuGONIO[8] = {
//     "-40dB to 6dB RMS",
//     "-40dB to 6dB PPM",
//     "-30dB to 6dB RMS",
//     "-30dB to 6dB PPM",
//     "-40dB to 6dB RMS HOLD",
//     "-40dB to 6dB PPM HOLD",
//     "-30dB to 6dB RMS HOLD",
//     "-30dB to 6dB PPM HOLD"
// };
