sonocotta/loud-esp/(commit log)

2022-03-15 Features/init repo (#1)
    * Added schematics and readme draft
    * Added audio test firmware
    * Added test peripheral firmware
    * Added submodules
    * Added project links
    * Added readme sceleton
    * wip
    * Update README.md
    * Update README.md
    * Update README.md
2022-08-10 Added SAM talking clock sample project
2022-09-25 Added battery voltage level test project
2022-09-27 Battery tets project almost finished
2023-03-02 Features/add va project (#4)
    * Added visualisation demo
    * Added visualisations demo project
    * Cleanup and build pipelines
    * Build pipline - ubuntu only
    * Build fixes
    * Build fixes
    ---------
    [AnalogVisualiser.h, BarsVisualiser.h, BufferedVisualiser.h, DigitalVisualiser.h, NotoSansBold36.h, SerialVisualiser.h, TextVisualiser.h]
2023-05-20 Added soundboard firmware fixes. Added sleep modes examples (#7)
    [main.cpp, player.hpp, screen.hpp]
2023-06-28 Added board images (#8)
    updated docs
    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
2023-09-06 Added EasyEDA PCB design files
    [loud-esp-mini-rev-f-pcb.easyeda.json, loud-esp-mini-rev-f-schematic.easyeda.json, loud-esp-rev-f-pcb.easyeda.json, loud-esp-rev-f-schematic.easyeda.json]
2023-12-14 Added pin usage summary
2024-06-12 Added esphome docs (#11)
    * Added esphome docs
    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
    [loud-esp-mopidy-monitor.yaml]
2025-05-30 Added rev H docs (#12)
    * Added Hw files and docs
    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
    [loud-esp-rev-f-pcb.easyeda.json, loud-esp-rev-f-schematic.easyeda.json]
