sonocotta/loud-esp/(notices)

Notices in the files:
firmware/test-audio/esp32-esp8266-audio-test-stream-web/src/web.cpp:
This program is free software: you can redistribute it and/or modify
it under the terms of the GNU General Public License as published by
the Free Software Foundation, either version 3 of the License, or
(at your option) any later version.
